AdityaRezan/8051-hardware-lab/docs/guide/video/frames/flash-wiring.jpg

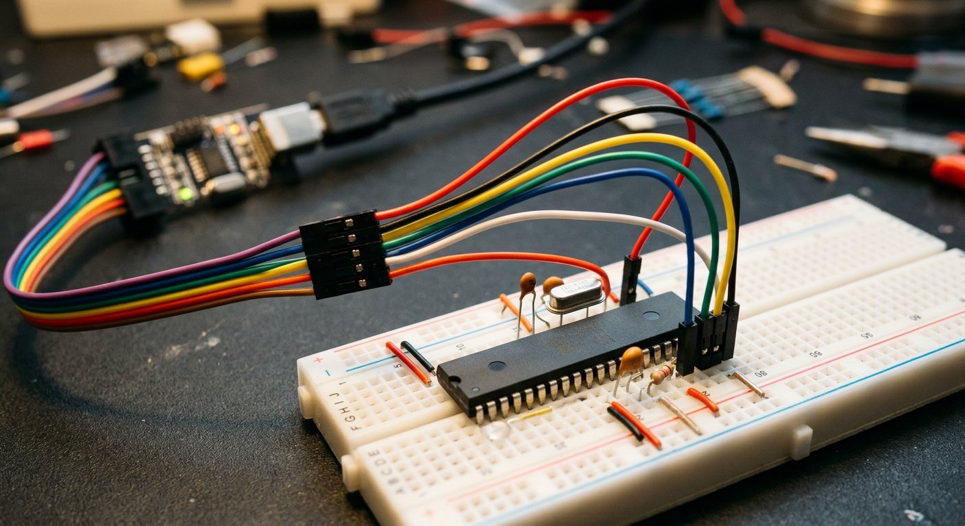
docs/guide/video/frames/flash-wiring.jpg
