AdityaRezan/8051-hardware-lab/docs/guide/images/dipswitch.jpg

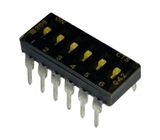
docs/guide/images/dipswitch.jpg
