AdityaRezan/8051-hardware-lab/README.md

# 8051 Hardware Lab

**Real-time embedded monitoring on the AT89S52 - from browser simulator to measured silicon.**

A complete, buildable 8051 board: shared-bus architecture, Keil C51 firmware, schematic with
derived design constants, bill of materials, a ten stage assembly procedure and twenty bench tests.

**Authors:** ATHARVA (24BEL0082) and ADITYA (24BEL0087)
**Department:** Electronics and Communication Engineering
**Academic year:** 2025-26

**New here? Read [`START_HERE.md`](START_HERE.md) first.** It walks the whole
project in the order you actually do it: install Keil, build all 13 programs,
build the board stage by stage, wire the programmer, flash, power on.

---

## The problem this project solves

The peripherals need **54 I/O lines**. The 8051 provides **32**.

| Peripheral | Dedicated pins | After bus sharing |
|---|---:|---:|
| LED latch, segment latch, LCD, ADC data | 32 | 8 |
| DIP switch bank | 8 | 8 |
| Control strobes | 0 | 8 |
| UART, interrupts, relay, buzzer, digit selects | 14 | 8 |
| **Total** | **54** | **32** |

The eight data lines of the LCD, the ADC and the two output latches are merged into one
bidirectional bus on port 0. Each device keeps its own enable strobe on port 2, so a transfer only
affects the device whose strobe is pulsed. No port expander IC is used.

---

## What the board does

| Function | Hardware | Firmware entry point |
|---|---|---|
| Eight LED output bank | 74HC573 latch plus 470 Ohm resistors | `led_write` |
| Eight bit digital input | 8-way DIP switch on port 1 | `switch_read` |
| Two digit numeric display | second latch, two BC547 digit drivers | `seg_tick` from timer 0 |
| Text output | 16x2 HD44780, 8-bit mode | `lcd_string`, `lcd_number` |
| Analog temperature | LM35 into ADC0804, Vref/2 at 1.000 V | `adc_read`, `adc_to_celsius` |
| Serial link | MAX232 and DB9 at 9600 8N1 | `uart_string`, `uart_number` |
| Interrupts | PB1 on INT0, PB2 on INT1, falling edge | `int0_isr`, `int1_isr` |
| Actuators | 5 V SPDT relay and buzzer on BC547 drivers | `RELAY`, `BUZZER` |
| Zone control | green, yellow, red LEDs plus relay and buzzer | `12_industrial_monitor.c` |

---

## Specification

| Parameter | Value |
|---|---|
| Microcontroller | AT89S52-24PU, 40-pin DIP (AT89C51 fallback, pin compatible) |
| Crystal | 11.0592 MHz |
| Machine cycle | 1.0851 microseconds |
| Supply | 7-12 V in, 5.00 V regulated by a 7805 with heatsink |
| Current | 157 mA typical, 274 mA peak |
| Digital I/O | 32 of 32 pins used |
| Serial | 9600 8N1, TH1 = FDH, zero percent error |
| ADC | 8-bit, Vref/2 = 1.000 V, 7.8125 mV per LSB |
| Temperature | 0 to 199.2 C at 0.78 C resolution |
| Display refresh | 100 Hz per digit from a 5 ms timer 0 interrupt |
| Cost | about INR 985 per board, INR 1,715 for a full setup |

---

## Repository layout

```
8051-hardware-lab/
├── hardware/
│   ├── SCHEMATIC.md      pin budget, pin allocation, wiring tables, design calculations
│   ├── BOM.md  BOM.csv   bill of materials with indicative Indian pricing
│   ├── ASSEMBLY.md       ten stage build procedure with a pass measurement per stage
│   ├── TESTING.md        twenty test cases, calibration, sample telemetry
│   └── min-system.svg    schematic of the minimum system
├── firmware/
│   ├── inc/board.h       pin definitions and all peripheral drivers
│   ├── src/01..13_*.c    thirteen standalone Keil C51 programs
│   ├── keil/*.uvprojx    uVision 5 projects for AT89S52 and AT89C51
│   ├── hex/              the 13 built HEX files, committed as the deliverable
│   └── README.md         Keil setup, flashing, program reference
├── docs/
│   ├── 8051_Hardware_Lab_Review_Deck.pptx   7 slide technical review deck
│   ├── 8051_Hardware_Implementation.pptx    28 slide detailed deck
│   ├── SOFTWARE_RUNBOOK.md  software half only: build, flash, run, lab day
│   ├── FACULTY_DEMO.md  demo-day playbook: bench setup, 12 min script, viva bank
│   ├── WORK_DIVISION.md the project in 13 parts, split between two authors
│   ├── RESULTS.md       what the results are, and the six minute one-on-one
│   ├── 8051_Results_Sheet.pdf  two page A4 sheet the reviewer holds
│   ├── DEMO_CARD.md     one printable page to keep under the board
│   └── guide/
│       ├── 8051_How_It_Works.pdf            18 page plain English guide
│       └── images/                          source photos and illustrations
│   ├── DECK_OUTLINE.md  wireframes, content spec and visual asset manifest
│   └── wireframes.svg   layout blueprints for all seven slides
├── tools/                generators for the decks, the BOM and the schematic
└── smart_industrial_automation.py    phase 1 simulation model
```

---

## Firmware

Thirteen Keil C51 programs. Each is a single translation unit that includes `inc/board.h`, so every
program builds as its own target.

| Program | Demonstrates |
|---|---|
| 01_led_blink | port expansion through a latch |
| 02_led_patterns | rotate and pattern sequences |
| 03_switch_led | debounced digital input |
| 04_seg7_counter | lookup table and multiplexed display |
| 05_timer0_second | timer interrupt timing |
| 06_square_wave | timer generated frequency |
| 07_ext_interrupt | INT0 and INT1 edge triggered ISRs |
| 08_uart_echo | 9600 baud serial link |
| 09_uart_commands | serial command shell |
| 10_adc_7seg | LM35 and ADC0804 |
| 11_adc_lcd | HD44780 8-bit interface |
| 12_industrial_monitor | complete system: zones, relay, buzzer, telemetry |
| 13_selftest | power on self test with a PASS or FAIL report |

Sources contain no comments and use only the C51 subset: `sbit`, `code`, `interrupt N`, C89
declarations. All thirteen compile clean. See `firmware/README.md` for the Keil setup and the
flashing procedure.

---

## Key design constants

Every value below derives from the 1.0851 microsecond machine cycle.

| Quantity | Value | Derivation |
|---|---|---|
| TH1 for 9600 baud | FDH | `256 - 11059200 / (384 x 9600) = 253` |
| Timer 0, 5 ms display tick | EE00H | `65536 - 5000 / 1.0851 = 60928` |
| Timer 0, 50 ms tick | 4C00H | `65536 - 50000 / 1.0851 = 19456` |
| Timer 0, 1 kHz output | FE34H | `65536 - 500 / 1.0851 = 65076` |
| ADC step | 7.8125 mV | `2.000 V / 256` |
| Temperature transfer | `T = raw x 25 / 32` | `raw x 7.8125 mV / 10 mV` |
| ADC clock | 606 kHz | `1 / (1.1 x 10 kOhm x 150 pF)` |
| LED resistor | 470 Ohm | keeps the latch package at 53 mA, under its 70 mA limit |

---

## Build and test

1. Read `hardware/SCHEMATIC.md` for the pin allocation and wiring tables.
2. Order parts from `hardware/BOM.csv`.
3. Follow `hardware/ASSEMBLY.md`, ten stages, measuring at the end of each.
4. Flash a program from `firmware/src` with a USBasp.
5. Run the twenty tests in `hardware/TESTING.md` and record the measured column.

---

## Presentation decks

| Deck | Slides | Use |
|---|---:|---|
| `docs/8051_Hardware_Lab_Review_Deck.pptx` | 7 | technical review committee, executive summary |
| `docs/8051_Hardware_Implementation.pptx` | 28 | detailed walkthrough, full subsystem coverage |

The seven slide deck is built to an explicit design system: charcoal `#1E293B`, off-white
`#F1F5F9`, Electric Blue `#2563EB` and Emerald `#10B981`, on a 12 column grid. Its layout
wireframes, per-slide content specification and visual asset manifest are in
`docs/DECK_OUTLINE.md`, and `docs/wireframes.svg` is the blueprint contact sheet.

Rebuild either deck with:

```
pip install python-pptx
python3 tools/build_exec_deck.py      # 7 slide review deck
python3 tools/build_deck.py           # 28 slide detailed deck
python3 tools/gen_wireframes.py       # docs/wireframes.svg
python3 tools/build_guide_pdf.py      # docs/guide/8051_How_It_Works.pdf
python3 tools/build_video.py          # docs/guide/video/8051_Assembly_and_Run.mp4
python3 tools/gen_bom.py              # hardware/BOM.md
python3 tools/gen_min_system_svg.py   # hardware/min-system.svg
python3 tools/build_results_pdf.py    # docs/8051_Results_Sheet.pdf
```

---

## Plain English guide

`docs/guide/8051_How_It_Works.pdf` is an 18 page guide written for a reader with no
electronics background. It covers the two halves of the project separately, then the join
between them, then the physical build, then two full walkthroughs (a button press and a rise
in temperature), and finishes with test results, a glossary and a script for presenting the
work. It uses real photographs of every part alongside three generated illustrations of the
concepts that cannot be photographed, namely the shared bus, the boundary between code and
pin, and the four beat control loop.

| Page | Subject |
|---|---|
| 1 | Cover |
| 2 | The whole project in one paragraph |
| 3 | Two halves of one machine |
| 4 | The parts you can touch |
| 5 | The parts that make the rest work |
| 6 | The code: thirteen small programs |
| 7 | Where the software touches the metal |
| 8 | The problem: 54 wires, 32 pins |
| 9 | The fix: one road, many gates |
| 10 | The loop: read, convert, decide, act |
| 11 to 12 | Building it, stage by stage |
| 13 to 14 | What happens when you press the button, and when the room gets hot |
| 15 | How we checked it was right |
| 16 | The numbers |
| 17 | Plain English glossary |
| 18 | How to present this project |

Rebuild with `python3 tools/build_guide_pdf.py`. It needs `weasyprint` and `pillow`.

## Video

There are two narrated videos, both 1280 by 720 at 24 fps with burned in
captions, so both read with the sound off.

| Video | Length | What it covers |
|---|---|---|
| `8051_Start_To_Finish.mp4` | 6:43 | The whole project from an empty desk: installing Keil on the laptop, `board.h` and the pin map, writing and building to a `.hex` file, all ten assembly stages, then flashing over SPI and running the system |
| `8051_Assembly_and_Run.mp4` | 5:13 | Assembly focused cut: the 54 versus 32 pin constraint, the shared bus fix, the ten build stages, and the board running |

Start with `8051_Start_To_Finish.mp4` if you want the complete story. The
shorter one is the better pick if you only have five minutes.

Both videos show real source code on screen. The excerpts in the code panels are
read out of `firmware/inc/board.h` and `firmware/src/12_industrial_monitor.c` at
build time, so they cannot drift from the actual firmware.

| File | What it is |
|---|---|
| `8051_Start_To_Finish.mp4` | the full start to finish video |
| `8051_Assembly_and_Run.mp4` | the shorter assembly cut |
| `SHOOTING_SCRIPT.md` | shot by shot script for filming the real board to the same narration |
| `audio/`, `audio_full/` | recorded narration clips, one per scene, per video |
| `frames/` | generated board and bench images used as source frames |

The board and bench images are generated: they show the build rather than
photograph it, because no camera was available. `SHOOTING_SCRIPT.md` has the
timecodes, camera setup and cut list needed to replace them with real footage of
the bench without re-recording anything.

The board images are generated: they show the build rather than photograph it,
because no camera was available. `SHOOTING_SCRIPT.md` has the timecodes, camera
setup and cut list needed to replace them with real footage of the bench
without re-recording anything.

Rebuild with:

```
python3 tools/build_video.py                    # 5:13 assembly cut, about 4 min
python3 tools/build_video.py --script full      # 6:43 full start to finish, about 5 min
python3 tools/build_video.py --script full --shot 340   # one frame, for tweaking
```

## Working on your own laptop

`docs/LAPTOP_SETUP.md` covers installing Keil C51, opening the 26 ready made
uVision projects, and building to a `.hex` file. `docs/SOFTWARE_RUNBOOK.md`
compresses the software half into one tick-box list with a minute-by-minute lab
day timeline, from installing Keil to a board that boots on its own power.
`docs/FLASHING.md` then covers
getting that file into the chip: the six ISP wires, an Arduino as ISP, USBasp,
ProgISP, and a fault table. Together they cover four things that reliably waste
a day:

- The free Keil C51 evaluation version is capped at **2 KB of object code** and
  links at offset `0x0800`. Program 01 measures `data=30.0 code=1129` on that
  toolchain, and every program carries the whole of `board.h`, so the later ones
  sit close to the cap. Enabling the LX51 linker with `REMOVEUNUSED` drops the
  unused drivers and buys a lot of room.
- The `0x0800` offset is harmless on an 8 KB part. The linker plants an `LJMP`
  at address 0x0000, so the chip boots and runs normally. It only matters on a
  2 KB device such as an AT89C2051.
- A **stock USBasp cannot program an AT89S52**. AVR chips reset on a low signal
  and the 8051 resets on a high one, so stock firmware never gets the chip into
  programming mode. Use an Arduino as ISP or a dedicated 8051 programmer.
- The **AT89C51 cannot be ISP programmed at all**. It needs a parallel
  programmer with 12 V VPP. The `_AT89C51` projects compile, but use the
  `_AT89S52` ones for hardware.

For licence free checking at home on any operating system, `tools/check_sdcc.py`
compiles all 13 programs with SDCC in a scratch directory and reports code
sizes. It translates the Keil syntax automatically and never modifies the files
in `firmware/`.

```
python3 tools/check_sdcc.py          # needs sdcc on PATH
python3 tools/check_sdcc.py 05 12    # only those two programs
```

## Safety

- The relay is mains rated but must never be connected to mains during laboratory demonstration.
  Use a 5 V or 12 V lamp on J4, or leave the contacts open.
- The 7805 dissipates about 1 W at 9 V and 250 mA. Fit the heatsink.
- Disconnect power before inserting or removing the microcontroller.
- Set DIP switches 6, 7 and 8 to OFF before every programming cycle; they share P1.5 to P1.7 with
  the SPI programming lines.
