AdityaRezan/8051-hardware-lab/docs/8051_Hardware_Lab_Review_Deck.pptx

MINI PROJECT / MICROPROCESSORS AND MICROCONTROLLERS

8051 Hardware Lab

Real-time embedded monitoring on the AT89S52

From browser simulator to measured silicon in one build cycle

Authors ATHARVA (24BEL0082) - ADITYA (24BEL0087)

Department Electronics and Communication Engineering

Academic year 2025 - 26

Review Technical Review Committee

Artifacts Schematic, BOM, 13 Keil C51 programs, test report

AT89S52

SYSTEM ID

Target AT89S52-24PU

Clock 11.0592 MHz

Bus 8-bit shared, P0

Firmware Keil C51, 13 programs

32 / 32

I/O PINS UTILISED

full allocation, no headroom

0.00 %

UART BAUD ERROR

TH1 = FDH at 11.0592 MHz

0.78 C

ADC RESOLUTION

Vref/2 trimmed to 1.000 V

INR 985

BOM PER BOARD

through-hole, single unit

## Slide 2

SLIDE 02 / PROBLEM

Problem statement and constraints

What had to be solved before a single component was placed

ID | Constraint | Consequence if ignored | Mitigation in this design
C1 | 32 I/O pins for 54 signals | peripherals dropped, or an expander IC added | single 8-bit bus on P0 with per-device strobes on P2
C2 | P0 is open drain | the bus never reaches a valid logic 1 | RN1, a 10 kOhm x 9 SIP network, pulls the bus up
C3 | Output latches cannot be read | a stale byte is latched into the wrong device | bus_shadow variable plus interrupt gating on transfers
C4 | SW6-SW8 share the ISP lines | in-circuit programming fails or is corrupted | 1 kOhm series resistors and a documented OFF state
C5 | 8-bit ADC, 5 V default reference | 1.95 C per step, most of the range wasted | Vref/2 trimmed to 1.000 V, giving 0.78 C per step
C6 | No hardware debounce on the buttons | one press registers as several interrupts | 5 ms resampling and edge triggered IT0 and IT1

PROBLEM STATEMENT

Transfer the verified 8051 programs from a software model onto a physical AT89S52, interfacing eight LEDs, a two digit seven segment display, a 16x2 character LCD, an eight way DIP switch bank, an LM35 temperature sensor through an ADC0804, a MAX232 serial link, a relay and a buzzer, and confirm on the bench that every output matches the value the simulator predicted.

Hard constraint:
the peripherals require 54 I/O lines and the 8051 provides 32. The architecture must close a 22 pin deficit without adding a port expander IC.

DESIGN CONSTRAINTS

I/O budget 54 required, 32 available

Port 0 topology open drain, cannot source

Latch read-back no read path to the latches

ISP contention P1.5-P1.7 shared with SPI

ADC resolution 8 bits, reference is a choice

No HW debounce buttons bounce 1 to 10 ms

constraint register C1-C6

8051 HARDWARE LAB / ECE 2025-26

02 / 07

## Slide 3

SLIDE 03 / ARCHITECTURE

System block diagram

One shared 8-bit bus resolves the 22 pin deficit

BD0 - BD7 shared 8-bit data bus port 0 10 kOhm pull-ups

Interface | Width | Signals | Direction | Device
Parallel bus | 8 bit | BD0-BD7 | bidirectional | U2 U3 LCD1 U4
Latch strobe | 1 bit | LED_LE SEG_LE | output | U2 U3
LCD control | 3 bit | E RS RW | output | LCD1
ADC control | 3 bit | WR RD INTR | in / out | U4
Serial + GPIO | 6 bit | TxD RxD P3.4-P3.7 | both | MAX232 Q1-Q4

SW1 8-way DIP

P1.0-P1.7

AT89S52-24PU

40-pin DIP / 11.0592 MHz

Relay + buzzer

P3.4 / P3.5

PB1 / PB2

P3.2 / P3.3

Digit selects

P3.6 / P3.7

LM35 sensor

ADC Vin+

MAX232 / DB9

P3.0 / P3.1

U2 74HC573

8 LEDs

P2.0 LED_LE

U3 74HC573

7-segment x2

P2.1 SEG_LE

LCD1 16x2

HD44780 8-bit

P2.2-P2.4 E RS RW

U4 ADC0804

LM35 8-bit

P2.5-P2.7 WR RD INTR

PIN ECONOMY

54 pins required -> 32 available
Three 8-bit data paths merged into one bus, saving 24 pins.
Eight of them pay for the strobes. Net saving: 16 pins.

single bus, four devices, eight strobes

8051 HARDWARE LAB / ECE 2025-26

03 / 07

## Slide 4

SLIDE 04 / STACK

Hardware and software stack

Four layers, one board, no operating system

13 firmware programs / board.h / 01 blink to 13 self test

bus, LED, 7-segment, LCD, ADC, UART, switch debounce

8-bit parallel / HD44780 8-bit / ADC0804 / UART 9600 8N1

AT89S52 2x 74HC573 ADC0804 LM35 MAX232 HD44780 BC547 x4 7805

APPLICATION

firmware/src

DRIVER

firmware/inc/board.h

INTERFACE

P0, P2, P3

SILICON

through-hole DIP

AT89S52-24PU

MCU

8 KB flash, 3 timers

74HC573 x2

LATCH

LED bank, segment patterns

ADC0804LCN

ADC

8-bit parallel, 606 kHz

LM35DZ

SENSOR

10 mV per degree C

MAX232N

TRANSCEIVER

TTL to RS-232, 1 uF pump

JHD162A

DISPLAY

16x2 HD44780, 8-bit

BC547 x4

DRIVER

digits, relay, buzzer

L7805CV

REGULATOR

5.00 V, 1 W, heatsinked

Protocol | Pins | Used for
8-bit parallel bus | P0.0-P0.7 | latches, LCD, ADC
UART 9600 8N1 | P3.0-P3.1 | telemetry and shell
SPI (ISP only) | P1.5-P1.7 | flash programming

8051 HARDWARE LAB / ECE 2025-26

TOOLCHAIN

Keil uVision 5, C51, level 8, small memory model
USBasp + avrdude -p 8052 USB-RS232 DMM 20 MHz scope

no RTOS, no external memory, one translation unit per program

04 / 07

## Slide 5

SLIDE 05 / IMPLEMENTATION

Implementation logic and control flow

Interrupt driven display refresh around a polling control loop

board_init

ports, latches, outputs off

TIMER 0 ISR / EVERY 5 ms

TH0 = EEH TL0 = 00H
seg_tick() alternates the two digits
saves and restores the bus shadow byte

Stage | Operation | Failure mode handled
Acquire | adc_read, INTR both edges | guarded timeout returns
Convert | T = raw x 25 / 32 integer | no float library needed
Decide | compare at 400 and 700 | emergency overrides all
Actuate | latch write, relay, buzzer | interrupts gated
Publish | LCD, 7-segment, UART 1 Hz | refresh runs in the ISR

Operation | Cycles | Time
machine cycle | 12 osc | 1.0851 us
bus transfer | ~20 | 21.7 us
ADC conversion | - | 114 us
LCD write | ~30 | 32.6 us
display tick | 4608 | 5.000 ms
telemetry period | - | 1.000 s

display_init

timer 0 at 5 ms, EE00H

adc_read

start, wait INTR, read byte

BUS TRANSFER PRIMITIVE

1 save

ea = EA

2 gate

EA = 0

zone decision

T < 40 / < 70 / >= 70 C

3 place

BUS = v

4 strobe

LE = 1

actuate

LEDs, relay, buzzer

5 release

LE = 0

6 restore

BUS = shadow

EXTERNAL INTERRUPTS

INT0 falling edge -> emergency latch
INT1 falling edge -> clear the latch
Both ISRs set a flag only; the main loop
does the work, keeping service short.

WHY POLL, WHY INTERRUPT

The display must never flicker, so it runs
in the interrupt. Sensing and acting can
slip by milliseconds, so they poll. Each
mechanism is matched to its own deadline.

publish

LCD, 7-segment, UART 1 Hz

poll in the loop, refresh in the interrupt

8051 HARDWARE LAB / ECE 2025-26

05 / 07

## Slide 6

SLIDE 06 / RESULTS

Results, benchmarks and trade-offs

Derived values, measured targets and the decisions behind them

Decision | Alternative rejected | Trade-off accepted | Outcome
Shared 8-bit bus | I2C or SPI port expander IC | 8 extra strobes and software arbitration | 54 pins fitted into 32, no extra IC
AT89S52 with ISP | AT89C51, parallel programmer | slightly higher chip cost | programmer cost falls to INR 250
470 Ohm LED resistors | the usual 330 Ohm | about 15 % less brightness | 53 mA per package, inside the 70 mA limit
Vref/2 at 1.000 V | internal 2.5 V reference | one trimpot and one calibration step | 0.78 C per step instead of 1.95 C
Software driven bus | MOVX with an address latch | no hardware address decode | port 2 stays free for eight strobes
Flags inside the ISRs | doing the work in the ISR | one loop of latency | short, predictable service routines
Software debounce | RC filter or Schmitt trigger | 5 ms of loop time | no parts, no spare pins consumed

0.00 %

BAUD ERROR

TH1 = FDH at 11.0592 MHz

1.00 kHz

TIMER OUTPUT

FE34H reload, +0.17 %

100 Hz

DISPLAY REFRESH

EE00H reload, per digit

0.78 C

ADC RESOLUTION

7.8125 mV per step

157 mA

BOARD CURRENT

274 mA peak, relay on

3.4 KB

LARGEST PROGRAM

of 8 KB flash, 30 B RAM

20 bench tests, T1-T20, acceptance limits in hardware/TESTING.md

8051 HARDWARE LAB / ECE 2025-26

06 / 07

## Slide 7

SLIDE 07 / OUTLOOK

Scalability, future scope and conclusion

Where the architecture has headroom and where it does not

NOW

Single board, verified

13 programs, 20 tests

INR 985 per board

9600 baud telemetry

Recover two pins

LCD on a PCF8574 backpack

frees P2.3 and P2.4

adds I2C: RTC, EEPROM

Multi-node and PCB

RS-485 or ESP-01 link

KiCad two layer layout

mains rated enclosure

NEXT

LATER

CONCLUSION

A 22 pin deficit was closed by architecture, not by extra silicon.

Every constant derives from the 1.0851 microsecond machine cycle.

Thirteen programs compile clean; the build is staged and measured.

Every hardware result reconciles with the phase 1 simulator.

SCALABILITY LIMITS

shared P0 caps throughput, a few hundred kHz

one channel, 8-bit, about 114 us per sample

256 B RAM, no external data memory wired

two external sources, no priority nesting

demonstration only, never mains connected

Bus

ADC

Memory

Interrupts

Relay

repository: AdityaRezan/8051-hardware-lab

8051 HARDWARE LAB / ECE 2025-26

07 / 07
