AdityaRezan/8051-hardware-lab/docs/8051_Hardware_Implementation.pptx

MINI PROJECT - MICROPROCESSORS AND MICROCONTROLLERS

8051 Microcontroller:
Architecture Study, Assembly Programming and Simulation

Phase 2 - Hardware Implementation on a Real AT89S52

Target device: AT89S52-24PU, 40 pin DIP

Clock: 11.0592 MHz, 1.0851 us machine cycle

I/O used: 32 of 32 pins, shared 8-bit bus

Cost: about INR 985 per board

PHASE 2

Simulator verified 14 assembly and 5 C programs.
This phase builds the board, writes Keil C51 firmware, and measures every signal.

ACADEMIC YEAR
2025 - 26
Microprocessors and Microcontrollers

SUBMITTED BY
ATHARVA (24BEL0082) ADITYA (24BEL0087)
Department of Electronics and Communication Engineering

## Slide 2

OVERVIEW

From simulator to silicon

What phase 1 delivered and what phase 2 adds

What changes when the machine becomes real

Aspect | In the simulator | On the hardware
I/O | Ports written directly | Shared bus with latch strobes
Timing | Idealised machine cycles | 1.0851 us per cycle, measured on a scope
Inputs | Clicked switches, ideal | Bounce, pull-ups, noise, debounce needed
Analog | Slider sets the temperature | LM35 into ADC0804, reference must be calibrated
Serial | Terminal pane | MAX232, DB9 wiring, 9600 8N1
Failure | Program stops | Wrong Vref, reversed sensor, floating EA pin
Verification | Compare with hand calculation | Compare with a multimeter and a scope

8051 Microcontroller Hardware Lab | ATHARVA (24BEL0082) - ADITYA (24BEL0087)

PHASE 1 - DIGITAL MODEL (COMPLETE)

A browser based 8051 trainer with a two pass assembler and an instruction level simulator.
Fourteen assembly programs and five Embedded C programs were executed one instruction at a time and every register, flag and memory change was compared with hand calculation.
All fourteen programs verified.

PHASE 2 - REAL HARDWARE (THIS DECK)

The same ideas built on an AT89S52 with latches, a real ADC, a character LCD, a MAX232 serial link, a relay and a buzzer.
Thirteen Keil C51 programs replace the assembly sources, the board is assembled in ten measured stages, and twenty tests verify it on the bench.

2

## Slide 3

PROBLEM STATEMENT

Why the hardware phase is needed

"To transfer the verified 8051 programs from a software model to a physical AT89S52 trainer board, interfacing LEDs, a seven segment display, a DIP switch bank, a character LCD, an LM35 temperature sensor with an ADC0804, a MAX232 serial link, a relay and a buzzer, and to confirm on the bench that each output matches the value predicted by the simulator."

Difficulties the hardware phase has to solve

The peripherals need 54 I/O lines. The 8051 has 32. A shared 8-bit bus with latches closes the gap.

It cannot drive a logic 1 without pull-ups, and every bus transfer has to respect the resulting rise time.

Output states live in latches, so the firmware keeps a shadow byte for the bus and restores it after every transfer.

An 8-bit ADC needs a deliberate reference. Vref/2 is trimmed to 1.000 V so the LM35 range is used instead of wasted.

P1.5, P1.6 and P1.7 serve both the DIP switches and the SPI programming header, so the two must not fight.

8051 Microcontroller Hardware Lab | ATHARVA (24BEL0082) - ADITYA (24BEL0087)

1

Port shortage

2

Port 0 is open drain

3

No zero flag, no read back

4

Analog accuracy

5

Programming

3

## Slide 4

OBJECTIVES

What the hardware phase sets out to do

8051 Microcontroller Hardware Lab | ATHARVA (24BEL0082) - ADITYA (24BEL0087)

Build the minimum system

AT89S52 with an 11.0592 MHz crystal, a reset circuit, the EA strap and a regulated 5 V supply, verified by a 1.843 MHz signal on ALE.

Solve the port shortage

Put the LCD, the ADC and two output latches on one 8-bit bus so all 32 pins cover every peripheral on the board.

Interface real output hardware

Eight LEDs behind a latch, a two digit multiplexed seven segment display, a 16x2 character LCD.

01

02

03

Interface real input hardware

An eight way DIP switch bank with pull-ups and debouncing, plus two interrupt push buttons on INT0 and INT1.

Measure something real

LM35 into an ADC0804 with a calibrated reference, converting raw codes to degrees Celsius and driving zone decisions.

Verify against the simulator

Twenty bench tests with acceptance limits, so each hardware result can be compared with the value the simulator produced.

04

05

06

4

## Slide 5

SYSTEM ARCHITECTURE

How the board is organised

One 8-bit bus, four devices behind latches and strobes

8051 Microcontroller Hardware Lab | ATHARVA (24BEL0082) - ADITYA (24BEL0087)

P1

8 DIP switches

AT89S52

40 pin DIP, 11.0592 MHz

P2.0 / P2.1

latch enables

P3.2 / P3.3

INT0 and INT1

P2.2-P2.4

LCD E, RS, RW

P3.4 / P3.5

relay and buzzer

P2.5-P2.7

ADC WR, RD, INTR

data bus

P0

shared data bus

P3.0 / P3.1

UART to MAX232

8-bit data bus BD0-BD7, port 0, 10 kOhm pull-ups

U2 74HC573

8 LEDs

U3 74HC573

7-segment

LCD1 16x2

HD44780

U4 ADC0804

LM35

5

## Slide 6

DESIGN PROBLEM

The 8051 has 32 I/O pins and the board needs 54

Peripheral | Dedicated pins | After bus sharing | How the saving is made
8 LED output bank | 8 | 0 | moves behind latch U2 on the bus
7-segment segment lines | 8 | 0 | moves behind latch U3 on the bus
16x2 LCD | 11 | 3 | data lines move to the bus, RS RW E stay
ADC0804 | 11 | 3 | data lines move to the bus, WR RD INTR stay
8 way DIP switch | 8 | 8 | stays on port 1
Digit selects | 2 | 2 | stays on P3.6 and P3.7
UART | 2 | 2 | stays on P3.0 and P3.1
Interrupt buttons | 2 | 2 | stays on P3.2 and P3.3
Relay and buzzer | 2 | 2 | stays on P3.4 and P3.5
Control strobes | 0 | 8 | new: enables on port 2, replace the per-device data pins
TOTAL | 54 | 32 | exactly the 32 pins the 8051 provides

Bus rule used everywhere in the firmware:
place the byte on P0, pulse the enable, restore the shadow byte. Interrupts are disabled during LCD and ADC transfers so the 5 ms display refresh cannot corrupt a bus cycle.

8051 Microcontroller Hardware Lab | ATHARVA (24BEL0082) - ADITYA (24BEL0087)

Why this works

The LCD, the ADC and the two latches only hold data. None of them needs to be driven continuously.

Each one keeps its own enable line on port 2. A transfer writes a byte to port 0 and pulses exactly one enable, so only the addressed device captures the byte.

The bus is driven by software rather than by MOVX, which keeps port 2 free for those eight strobes and keeps the code readable.

6

## Slide 7

PIN ALLOCATION

All 32 pins accounted for

AT89S52, 40 pin plastic DIP, 11.0592 MHz

Three traps that make a board look dead
EA/VPP (pin 31) floating - the device fetches code from external memory and never runs.
P0 used without RN1 pull-ups - port 0 is open drain and cannot drive a logic 1.
DIP switches 6, 7 and 8 closed while programming - they short the SPI lines on P1.5 to P1.7.

8051 Microcontroller Hardware Lab | ATHARVA (24BEL0082) - ADITYA (24BEL0087)

Pin | Signal | Board net
39-32 | P0.0-P0.7 | BD0-BD7 shared data bus
1-5 | P1.0-P1.4 | SW1-SW5
6-8 | P1.5-P1.7 | SW6-SW8 and MOSI, MISO, SCK
21 | P2.0 | LED_LE
22 | P2.1 | SEG_LE
23 | P2.2 | LCD_E
24 | P2.3 | LCD_RS
25 | P2.4 | LCD_RW
26 | P2.5 | ADC_WR
27 | P2.6 | ADC_RD
28 | P2.7 | ADC_INTR

Pin | Signal | Board net
10 | P3.0 RxD | MAX232 R1OUT
11 | P3.1 TxD | MAX232 T1IN
12 | P3.2 INT0 | PB1 emergency button
13 | P3.3 INT1 | PB2 mode button
14 | P3.4 T0 | relay driver via JP1
15 | P3.5 T1 | buzzer driver
16 | P3.6 WR | DIG1 digit select
17 | P3.7 RD | DIG2 digit select
9 | RST | reset RC and PB3, ISP pin 5
18 | XTAL2 | crystal and 30 pF
19 | XTAL1 | crystal and 30 pF
31 | EA/VPP | tied to +5 V

7

## Slide 8

MINIMUM SYSTEM

Clock, reset, EA strap and decoupling

Four parts decide whether the board runs at all

Part | Value | Purpose | Measured
Y1 crystal | 11.0592 MHz | clock; gives exact 9600 baud | 11.0592 MHz on pin 18
C3a, C3b | 30 pF | crystal load capacitors | -
R1 | 10 kOhm | holds RST low in steady state | -
C2 | 10 uF | holds RST high for about 100 ms at power up | RST low when idle
PB3 | tactile | manual reset to +5 V | RST above 4 V when held
EA strap | wire to +5 V | selects internal flash | 5.00 V on pin 31
C1 | 0.1 uF | decoupling across pins 40 and 20 | 5.00 V, no ripple spike
ALE | output | clock divided by 6 | 1.843 MHz

TIMING

machine cycle = 12 oscillator periods
Tcy = 12 / 11.0592 MHz = 1.0851 microseconds
ALE = fosc / 6 = 1.8432 MHz (fastest proof the device is running)

8051 Microcontroller Hardware Lab | ATHARVA (24BEL0082) - ADITYA (24BEL0087)

AT89S52 (U1)

pin 40 VCC 5.00 V

pin 20 GND

pin 31 EA -> +5 V

pin 19 XTAL1

pin 18 XTAL2

pin 9 RST

pin 30 ALE

Reset rule
RST must stay above 1.2 V for at least two machine cycles, about 2.2 us.
The RC gives about 100 ms.

8

## Slide 9

SHARED BUS

How one byte reaches one device

The four steps every transfer follows, and why the shadow byte exists

8051 Microcontroller Hardware Lab | ATHARVA (24BEL0082) - ADITYA (24BEL0087)

Place the byte

BUS = value; the byte appears on P0.0 to P0.7 and is copied into bus_shadow.

Disable interrupts

EA = 0, so the 5 ms display refresh cannot overwrite the bus half way through.

Pulse the enable

One strobe line on port 2 goes high for about 2.7 us. Only the device wired to that strobe captures the byte.

Restore the bus

BUS = bus_shadow, then EA is restored. The other three devices never saw a strobe, so they are unaffected.

1

2

3

4

firmware/inc/board.h

void led_write(unsigned char v)
{
unsigned char ea_state;
ea_state = EA;
EA = 0;
bus_put(v);
LED_LE = 1;
delay_short();
LED_LE = 0;
EA = ea_state;
}

Why the shadow byte is not optional

Port 0 is quasi-bidirectional and open drain. Reading back a latch output is not possible, so the last value written is kept in a variable.

The display refresh interrupt writes segment patterns to the same bus every 5 ms. Without saving, restoring and gating, an interrupt landing between the byte and the strobe would load the wrong value into the LED latch and produce visible glitches.

The same pattern is used by seg_latch, lcd_write and adc_read.

9

## Slide 10

OUTPUT STAGE

Eight LED bank behind a 74HC573 latch

Active high outputs, one current limiting resistor per LED

Parameter | Value | Reason
Latch type | 74HC573 | transparent latch, CMOS inputs suit the port 0 pull-ups
Latch enable | P2.0 | rising edge captures the byte
Output enable | tied to GND | outputs permanently valid
Series resistor | 470 Ohm | 8 x 6.6 mA = 53 mA, inside the 70 mA package limit
Resistor not used | 330 Ohm | would give 75 mA and exceed the package rating
LED polarity | active high | latch output high lights the LED

led_write(0x0F); /* lower four LEDs on */
led_write(0xF0); /* upper four LEDs on */

8051 Microcontroller Hardware Lab | ATHARVA (24BEL0082) - ADITYA (24BEL0087)

P0 bus

BD0-BD7

U2 74HC573

LE <- P2.0, OE tied low

RN3

470 Ohm x 8

8 LEDs

to GND

Current arithmetic

I per LED = (5.0 - 1.9) / 470 = 6.6 mA
I per package = 8 x 6.6 = 53 mA
74HC573 package limit = 70 mA

Headroom = 17 mA, which is why 470 Ohm is specified instead of the more usual 330 Ohm. Brightness at 6.6 mA is ample for a modern high efficiency indicator.

10

## Slide 11

DISPLAY STAGE

Two digit seven segment display

Latched segments, transistor switched digits, 100 Hz refresh

Multiplexing
Timer 0 interrupts every 5 ms. The service routine turns both digits off, latches the digit 1 pattern, raises P3.6, and on the next interrupt does the same for digit 2 with P3.7.
Refresh rate per digit = 1 / (2 x 5 ms) = 100 Hz, above the flicker fusion limit.
Reload value: 65536 - 4608 = 60928 = EE00H, so TH0 = EEH and TL0 = 00H.

8051 Microcontroller Hardware Lab | ATHARVA (24BEL0082) - ADITYA (24BEL0087)

U3 74HC573

LE <- P2.1

RN4 470 Ohm

a b c d e f g dp

DSP1

2 digit common cathode

P0 bus

BD0-BD7

Digit cathodes

Q1 BC547

digit 1

Q2 BC547

digit 2

Digit | Pattern | Digit | Pattern | Note
0 | 3FH | 5 | 6DH | Q0 = a
1 | 06H | 6 | 7DH | Q1 = b
2 | 5BH | 7 | 07H | Q2 = c
3 | 4FH | 8 | 7FH | Q3 = d
4 | 66H | 9 | 6FH | Q4 = e

Bases via 4.7 kOhm from P3.6 and P3.7. Emitters to GND. A logic 1 on the base pulls the digit cathode to ground and lights that digit.

11

## Slide 12

INPUT STAGE

DIP switches, pull-ups and interrupt buttons

Every input is active low, so a closed switch reads as zero

Debouncing

8051 Microcontroller Hardware Lab | ATHARVA (24BEL0082) - ADITYA (24BEL0087)

Eight way DIP switch on port 1

Each contact pulls its pin to ground through the switch. RN2, a 10 kOhm x 9 SIP network, pulls every pin back to +5 V when the switch is open.

Closed reads 0, open reads 1. Port 1 has internal pull-ups, so the board would work without RN2, but the external network makes the input immune to noise on long breadboard wires.

P1.5, P1.6 and P1.7 have 1 kOhm series resistors so a closed switch cannot fight the ISP programmer during flashing.

Interrupt push buttons

PB1 on P3.2 (INT0) and PB2 on P3.3 (INT1), each pulled up by 4.7 kOhm and switching to ground.

TCON is set with IT0 = 1 and IT1 = 1 so the 8051 detects the falling edge, giving one interrupt per press.

The service routines only set a flag. All the work is done in the main loop, which keeps the interrupt short and makes the behaviour easy to reason about.

unsigned char switch_read(void)
{
unsigned char a, b;
a = SWITCH;
do { delay_ms(5); b = SWITCH; } while (b != a);
return b;
}

Why 5 ms

A mechanical contact bounces for 1 to 10 ms. Sampling every 5 ms until two consecutive reads agree removes the bounce without slowing the response, because the whole loop finishes in one or two samples.

12

## Slide 13

ANALOG INPUT

LM35 temperature sensor with an ADC0804

Vref/2 trimmed to 1.000 V so the sensor range is used, not wasted

Quantity | Value | Note
Vref/2 (pin 9) | 1.000 V | set with the R8 trimpot, not left open
Full scale input | 2.000 V | twice the reference voltage
Step size | 7.8125 mV | 2.000 V / 256
Temperature per step | 0.781 degree C | 7.8125 mV / (10 mV per degree C)
Transfer function | T = raw x 25 / 32 | integer arithmetic, no float library
Range | 0 to 199.2 degree C | well past anything the LM35 sees in a lab
Clock | 606 kHz | 1 / (1.1 x 10 kOhm x 150 pF)
Conversion time | about 114 us | 66 to 73 clock periods
LM35 output at 30 C | 300 mV | raw code 38, displayed 29

8051 Microcontroller Hardware Lab | ATHARVA (24BEL0082) - ADITYA (24BEL0087)

ADC0804

Vin+ pin 6, Vin- to GND

P0 bus

DB0-DB7

8051

adc_read()

LM35

10 mV per degree C

control

WR P2.5
RD P2.6
INTR P2.7

Read sequence
Pulse WR low to start. Wait for INTR to go high, then low. Drive RD low, read the byte, release RD.

Why not leave Vref/2 open
An open pin selects the internal 2.5 V reference, giving 0 to 5 V full scale. The LM35 only reaches 1.5 V at 150 C, so more than two thirds of the range would be wasted and the resolution would be 1.95 degrees C instead of 0.78.

13

## Slide 14

TEXT OUTPUT

16x2 character LCD on the shared bus

HD44780 compatible module in 8-bit mode, three control lines

LCD pin | Name | Connected to | Function
1 | VSS | GND | ground
2 | VDD | +5 V | logic supply, 0.1 uF to ground
3 | VO | R9 wiper | contrast, about 0.5 to 1.0 V
4 | RS | P2.3 | 0 = command, 1 = character data
5 | RW | P2.4 | 0 = write, 1 = read
6 | E | P2.2 | enable, data taken on the falling edge
7-14 | D0-D7 | BD0-BD7 | 8-bit data on the shared bus
15 | A | +5 V via 220 Ohm | backlight anode
16 | K | GND | backlight cathode

Timing and the shared bus
The enable pulse stays high for about 8 machine cycles, roughly 8.7 us, far above the 450 ns minimum the HD44780 needs. Commands wait 2 ms afterwards so the clear and home instructions can complete.
Because the data pins sit on the shared bus, lcd_write brackets the transfer the same way as every other driver: save, write, strobe, restore, with interrupts disabled.
RW is driven from P2.4 so the busy flag can be polled. The shipped driver uses fixed delays instead, so RW may be tied to ground to free one pin.

8051 Microcontroller Hardware Lab | ATHARVA (24BEL0082) - ADITYA (24BEL0087)

INITIALISATION

lcd_cmd(0x38); /* 8-bit, 2 lines, 5x7 */
lcd_cmd(0x0C); /* display on, cursor off*/
lcd_cmd(0x06); /* increment on write */
lcd_cmd(0x01); /* clear display */
lcd_gotoxy(0, 0);
lcd_string("8051 HARDWARE");

14

## Slide 15

SERIAL LINK

MAX232 and DB9 at 9600 baud

The reason the board uses 11.0592 MHz instead of 12 MHz

8051 Microcontroller Hardware Lab | ATHARVA (24BEL0082) - ADITYA (24BEL0087)

MAX232 pin | Name | Connected to
1, 3 | C1+ , C1- | C7a, 1 uF
4, 5 | C2+ , C2- | C7b, 1 uF
2 | V+ | C7c to +5 V, not to ground
6 | V- | C7d, positive leg to ground
11 | T1IN | P3.1 TxD
12 | R1OUT | P3.0 RxD
13 | R1IN | DB9 pin 3
14 | T1OUT | DB9 pin 2
15, 16 | GND, VCC | ground and +5 V

Configuration
SCON = 0x50 mode 1, 8 data bits, receive enabled
TMOD timer 1 in mode 2, 8-bit auto reload
PCON SMOD cleared
Error 0.0 percent at 11.0592 MHz
Error 8.5 percent at 12 MHz, which fails

BAUD RATE

TH1 = 256 - (11059200 / (384 x 9600))
= 256 - 3 = 253 = 0xFD
SMOD = 0, timer 1 in mode 2

DB9 wiring

The board connector is wired as DCE: T1OUT to pin 2 and R1IN to pin 3, so a straight through cable works with a USB to RS-232 adapter. If the terminal shows nothing, swap pins 2 and 3 first, then check that V+ is about +9 V and V- about -9 V.

TELEMETRY AT 9600 8N1

T=28.1C ADC=36 ZONE=SAFE FAN=0 BUZ=0
T=41.4C ADC=53 ZONE=WARNING FAN=1 BUZ=0
T=72.6C ADC=93 ZONE=DANGER FAN=1 BUZ=1
T=72.6C ADC=93 ZONE=EMERGENCY FAN=0 BUZ=1

15

## Slide 16

POWER

Regulated 5 V and the current budget

A 7805, its heatsink, and knowing how much current the board really draws

Supply chain
J1 barrel jack, 7 to 12 V in, centre positive -> 1N4007 reverse protection -> C4 100 uF and 0.1 uF -> L7805 with heatsink -> C5 100 uF and 0.1 uF -> 5 V rail
A 500 mA adapter is comfortable. Below 7 V input the 7805 drops out of regulation; above 12 V the dissipation becomes the limiting factor, not the current.

8051 Microcontroller Hardware Lab | ATHARVA (24BEL0082) - ADITYA (24BEL0087)

Load | Typical | Maximum
AT89S52 at 11.0592 MHz | 25 mA | 30 mA
U2 latch plus 8 LEDs | 53 mA | 53 mA
U3 latch plus one display digit | 53 mA | 53 mA
16x2 LCD logic and backlight | 10 mA | 14 mA
ADC0804 | 3 mA | 5 mA
MAX232 | 10 mA | 15 mA
LM35 | 0.1 mA | 0.2 mA
Transistor base currents | 3 mA | 4 mA
Relay coil when energised | 0 mA | 70 mA
Buzzer when sounding | 0 mA | 30 mA
TOTAL | 157 mA | 274 mA

Regulator dissipation

P = (Vin - Vout) x I = (9 - 5) x 0.25 = 1.0 W

One watt in a TO-220 without a heatsink runs hot enough to drop out. HS1 is not optional.

Decoupling

C1 0.1 uF across pins 40 and 20 of the microcontroller, plus one 0.1 uF capacitor at each of U2, U3, U4, U5, the LCD and the ADC. Ceramic, short leads, physically close to the pins.

16

## Slide 17

BILL OF MATERIALS

Parts, quantities and cost

Indicative Indian retail rates, 2025-26 academic year

Category | Line items | Cost (INR)
Semiconductors and ICs | AT89S52, two 74HC573, ADC0804, MAX232, LM35, 7805 | 397
Discretes | four BC547, two 1N4007, nine LEDs | 21
Displays, modules, actuators | 16x2 LCD, 2-digit display, 5 V relay, buzzer | 275
Switches and buttons | 8-way DIP switch, three tactile buttons | 39
Resistors and networks | four SIP networks, nine resistors, trimpot, pot | 82
Capacitors | crystal loads, electrolytics, ceramics, 1 uF pump caps | 35
Crystal | 11.0592 MHz | 12
Sockets, connectors, jumpers | IC sockets, DC jack, DB9, ISP header, terminals | 124
Power, PCB, wire, programmers | adapter, dot PCB, hookup wire, USBasp, USB-RS232 | 730
TOTAL, one complete setup | | 1,715
Recurring cost of a second board | the adapter and programmers are reused | 985

What is not on the bill
A digital multimeter and, ideally, a 20 MHz oscilloscope for the four tests that need one. Both are standard laboratory instruments and are shared across the batch.
A reference thermometer for calibrating the LM35 against a known temperature.

8051 Microcontroller Hardware Lab | ATHARVA (24BEL0082) - ADITYA (24BEL0087)

Sourcing notes

AT89S52 over AT89C51: SPI programming with a 250 rupee USBasp instead of a parallel programmer costing several thousand.

74HC573 over 74LS573: CMOS inputs suit port 0 pull-ups and load the bus less.

MAX232A or MAX3232 may be substituted with 0.1 uF pump capacitors.

The display must be common cathode; a common anode part inverts the whole design.

17

## Slide 18

FIRMWARE ARCHITECTURE

One header, thirteen programs

firmware/inc/board.h holds every pin definition and driver

bus_put, led_write, seg_latch, seg_tick

lcd_init, lcd_string, adc_read, uart_string

adc_to_celsius, seg_number, uart_number, lcd_number

main and the interrupt service routines

8051 Microcontroller Hardware Lab | ATHARVA (24BEL0082) - ADITYA (24BEL0087)

src/01 .. src/13

one file per program

Design rules

No comments in the sources
No emojis anywhere
C89 declarations only
Keil keywords: sbit, code, interrupt N
No printf, no floating point
Each program is one translation unit

inc/board.h

pin definitions, bus and peripheral drivers

Hardware layer

moves bytes and strobes the enables

Peripheral layer

device protocols and timing

Conversion layer

raw values to human units

Application layer

what each program actually does

18

## Slide 19

PROGRAM LIBRARY

Thirteen Keil C51 programs

Each builds as its own target and fits inside the 8 KB flash of the AT89S52

# | Program | Peripherals exercised | What to observe | Size

01 | led_blink | LED latch | eight LEDs toggle every 500 ms | 1.1 KB
02 | led_patterns | LED latch | running light, AAH, 55H, blink | 1.2 KB
03 | switch_led | DIP switches, LEDs | LEDs follow switches, flash above 80H | 1.2 KB
04 | seg7_counter | 7-segment, digits | 00 to 99 at two counts per second | 1.3 KB
05 | timer0_second | timer 0 | one second blink from the interrupt | 1.2 KB
06 | square_wave | timer 0, P3.4 | 1.00 kHz on a scope, JP1 removed | 1.1 KB
07 | ext_interrupt | INT0, INT1 | PB1 alternates 0FH and F0H, PB2 counts | 1.3 KB
08 | uart_echo | UART, MAX232 | banner and character echo | 1.4 KB
09 | uart_commands | UART, relay, buzzer | HLP, LED HH, SEG NN, RLY N, TMP | 3.0 KB
10 | adc_7seg | ADC0804, LM35 | temperature on the display | 1.5 KB
11 | adc_lcd | ADC, LCD | temperature and bar graph | 2.0 KB
12 | industrial_monitor | everything | zones, relay, buzzer, telemetry | 3.4 KB
13 | selftest | everything | PASS or FAIL report on the terminal | 2.6 KB

Verification:
all thirteen compiled with zero errors and zero warnings. The largest, program 12, uses about 40 percent of the flash and about 30 bytes of internal RAM.

8051 Microcontroller Hardware Lab | ATHARVA (24BEL0082) - ADITYA (24BEL0087)

19

## Slide 20

FIRMWARE TIMING

Every constant the programs depend on

All derived from one number: the 1.0851 microsecond machine cycle

Function | Register setting | Derivation | Result
UART 9600 baud | TH1 = TL1 = FDH | 256 - 11059200 / (384 x 9600) = 253 | 0.00 percent error
Display refresh 5 ms | TH0 = EEH, TL0 = 00H | 65536 - 5000 / 1.0851 = 60928 | 100 Hz per digit
50 ms tick | TH0 = 4CH, TL0 = 00H | 65536 - 50000 / 1.0851 = 19456 | 20 ticks = 1 s
1 kHz output | TH0 = FEH, TL0 = 34H | 65536 - 500 / 1.0851 = 65076 | 1001.7 Hz
Bus strobe width | 8 NOPs | 8 x 1.0851 us | 8.7 us, above all minimums
LCD command wait | delay_ms(2) | calibrated DJNZ loop | covers clear and home
Switch debounce | delay_ms(5) | two consecutive equal samples | 1 to 10 ms bounce removed
LM35 conversion | T = raw x 25 / 32 | raw x 7.8125 mV / 10 mV | 0.78 degree C per step

8051 Microcontroller Hardware Lab | ATHARVA (24BEL0082) - ADITYA (24BEL0087)

DISPLAY REFRESH INTERRUPT

void timer0_isr(void) interrupt 1
{
TH0 = TH0_5MS; /* EEH */
TL0 = TL0_5MS; /* 00H */
seg_tick();
ms_ticks++;
}

Calibration note

delay_ms is written for 11.0592 MHz and assumes the loop compiles to a DJNZ. Verify it once by timing program 05, which uses the hardware timer, against program 01, which uses delay_ms. If they disagree, trim the two literal 250 values in delay_1ms and leave the timer reloads alone.

20

## Slide 21

BUILD PROCEDURE

Ten stages, each with a pass measurement

Nothing is wired on top of a stage that has not been measured

Stage | What is built | Measurement that must pass
1 | Power: jack, 1N4007, 7805, capacitors | 5.00 V plus or minus 0.15 V at the regulator output
2 | Minimum system: socket, crystal, reset, EA | 1.843 MHz on ALE, RST below 0.5 V when idle
3 | LED latch U2 and the eight LEDs | all eight blink at 1 Hz, 6 to 7 mA each
4 | DIP switch bank and pull-ups | P1 reads FFH open, FEH with switch 1 closed
5 | Segment latch, display, digit transistors | counts 00 to 99 in about 50 s
6 | MAX232, pump capacitors, DB9 | banner on the terminal, V+ about +9 V
7 | ADC0804, LM35, reference trimpot | pin 9 at 1.000 V, about 606 kHz on pin 4
8 | 16x2 LCD and contrast pot | temperature text and a growing bar graph
9 | Relay, buzzer, driver transistors, JP1 | relay clicks at 40 C, buzzer above 70 C
10 | Final checkout with the self test | every line OK, final line SELF TEST: PASS

8051 Microcontroller Hardware Lab | ATHARVA (24BEL0082) - ADITYA (24BEL0087)

Order matters

Power first and alone. If the regulator is wrong, everything downstream is wrong.

The minimum system second, because ALE proves the device is running before any peripheral complicates the diagnosis.

Outputs before inputs, because an LED is the quickest way to see a state.

The ADC after the serial link, because the reference voltage is set and checked with the terminal connected.

Transfer to a soldered dot PCB only after the breadboard passes every test.

21

## Slide 22

VERIFICATION

Twenty bench tests with acceptance limits

A test passes only when the measured value is inside the stated limit

# | Test | Expected | # | Test | Expected

T1 | Power on self test | every line OK, PASS | T11 | LM35 accuracy | within 1.5 C, 25 to 60 C
T2 | Supply rails | 5.00 V plus or minus 0.15 V | T12 | LCD bar graph | increases monotonically
T3 | LED timing | 20 half cycles in 10.0 s | T13 | Zone thresholds | green, then 40 C, then 70 C
T4 | DIP switch input | correct LED within 10 ms | T14 | Relay control | energises at 40.0 C
T5 | Counter 00 to 99 | 50 s plus or minus 2 s | T15 | Emergency stop | relay off, buzzer on
T6 | One second timing | 10 transitions in 10.0 s | T16 | Emergency reset | returns to zone control
T7 | Square wave | 1.00 kHz plus or minus 20 Hz | T17 | Telemetry rate | 10 lines in 10 s
T8 | External interrupts | no double triggering | T18 | Current | below 200 mA
T9 | Serial loopback | every byte echoed | T19 | Regulator thermals | below about 60 C
T10 | Command shell | HLP, LED FF, RLY 1 all work | T20 | Supply rejection | 5 V holds, 7 V to 12 V

8051 Microcontroller Hardware Lab | ATHARVA (24BEL0082) - ADITYA (24BEL0087)

Calibration of the reference
Adjust R8 until ADC0804 pin 9 reads exactly 1.000 V. Confirm the transfer function against two temperatures at least 20 degrees apart. If both readings are off by the same factor, R8 has drifted; if only one is off, the LM35 is picking up noise.

Known limitation
Resolution is 0.78 degree C and accuracy is about plus or minus 1.5 degree C. That is entirely adequate for switching zones at 40 and 70 degrees, and is not a metrology grade measurement. The limitation is the 8-bit converter, not the sensor.

22

## Slide 23

RESULTS

What the board reports on the bench

Terminal capture at 9600 8N1, and the self test run

Check | Raw code | T = raw x 25 / 32 | Zone | Action
Room temperature | 36 | 28.1 C | SAFE | green LED, fan off
Warmed by hand | 53 | 41.4 C | WARNING | yellow LED, fan on
Near a heat source | 82 | 64.0 C | WARNING | yellow LED, fan on
Above the threshold | 93 | 72.6 C | DANGER | red LED, fan on, buzzer on
PB1 pressed | 93 | 72.6 C | EMERGENCY | fan off, buzzer on, latched

Every printed pair satisfies the transfer function, which is the arithmetic link between the analog hardware and the digital output.

8051 Microcontroller Hardware Lab | ATHARVA (24BEL0082) - ADITYA (24BEL0087)

PROGRAM 12 TELEMETRY, ONE LINE PER SECOND

8051 ZONE MONITOR 9600 8N1
T=28.1C ADC=36 ZONE=SAFE FAN=0 BUZ=0
T=28.1C ADC=36 ZONE=SAFE FAN=0 BUZ=0
T=41.4C ADC=53 ZONE=WARNING FAN=1 BUZ=0
T=64.0C ADC=82 ZONE=WARNING FAN=1 BUZ=0
T=72.6C ADC=93 ZONE=DANGER FAN=1 BUZ=1

PROGRAM 13 SELF TEST

8051 HARDWARE LAB
POWER ON SELF TEST
LED BANK : OK
7 SEGMENT : OK
RELAY DRIVER : OK

23

## Slide 24

DESIGN DECISIONS

Trade-offs made, and why

Decision | Alternative considered | Why this one was chosen
AT89S52 with ISP | AT89C51 with a parallel programmer | programmed with a 250 rupee USBasp; the C51 needs hardware costing several thousand
Software driven bus | MOVX with an address latch and decoder | port 2 stays free for eight strobes and the code stays readable for teaching
74HC573 latches | 74LS573 or 74HC373 | CMOS inputs suit the port 0 pull-ups and load the bus less
470 Ohm LED resistors | the usual 330 Ohm | keeps the package current at 53 mA, inside the 70 mA limit
Vref/2 at 1.000 V | internal 2.5 V reference | 0.78 degree C per step instead of 1.95, using the LM35 range properly
Software debounce | RC filter or a Schmitt trigger | no extra parts, and the pin count has no spares left
Common cathode display | common anode | NPN transistors switching ground are the simpler driver
Flags in the ISRs | doing the work inside the ISR | short service routines, predictable timing, behaviour easy to follow
11.0592 MHz crystal | 12 MHz | zero percent baud error instead of 8.5 percent

Every decision above keeps the board buildable with through-hole parts on a breadboard or dot PCB, which is the constraint a college laboratory actually has.

8051 Microcontroller Hardware Lab | ATHARVA (24BEL0082) - ADITYA (24BEL0087)

24

## Slide 25

SAFETY AND PRACTICE

Rules that keep the board and the bench safe

8051 Microcontroller Hardware Lab | ATHARVA (24BEL0082) - ADITYA (24BEL0087)

Never connect the relay to mains

The relay is mains rated but the demonstration uses a 5 V or 12 V lamp on J4, or leaves the contacts open entirely.

Fit the 7805 heatsink

About 1 W is dissipated at 9 V and 250 mA. Without the heatsink the regulator shuts down thermally.

Power off before handling the ICs

Inserting or removing the microcontroller with power applied latches the outputs and can destroy the part.

Switches 6, 7 and 8 OFF when flashing

They share P1.5 to P1.7 with the SPI lines and will corrupt the programming transfer.

Remove JP1 before probing P3.4

The relay coil loads the square wave output and gives a false reading on the scope.

Check the 5 V rail before anything else

A wrong rail damages every IC on the board at once, so it is measured with nothing else connected.

25

## Slide 26

CONCLUSION

The 8051 now runs on real silicon

8051 Microcontroller Hardware Lab | ATHARVA (24BEL0082) - ADITYA (24BEL0087)

The port shortage is solved

A single 8-bit bus on port 0 with per-device strobes on port 2 puts eight LEDs, a two digit display, a 16x2 LCD, an ADC, a relay and a buzzer on a device with 32 pins.

Every number is derived, not guessed

TH1 = FDH, TH0 = EE00H and 4C00H and FE34H, 470 Ohm resistors, 7.8125 mV per step and 606 kHz all follow from the 1.0851 microsecond machine cycle.

Thirteen programs, all compiling clean

From a blinking LED to a complete zone monitor with telemetry, written without comments in the C51 subset and verified for zero errors and zero warnings.

01

02

03

The build is staged and measured

Ten assembly stages each end with a measurement that must pass, and twenty tests with acceptance limits turn the demonstration into evidence.

The simulator and the hardware agree

Each hardware result can be checked against the value the simulator produced in phase 1, which is the point of having built the model first.

It is affordable and repeatable

About 985 rupees per board in through-hole parts, programmed with a 250 rupee USBasp, built on a breadboard or a dot PCB.

04

05

06

26

## Slide 27

FUTURE SCOPE

Where the board can go next

Direction | What it adds | What it needs
Complete instruction coverage | the rarely used instructions and the 8052 extras: timer 2 and 256 bytes of RAM | a second firmware pass, no new hardware
Peripheral depth | serial modes 0 and 2, the remaining timer modes, interrupt priority nesting | firmware only
More sensors | ADC0808 or ADC0809 for four or eight channels, an LDR, a potentiometer setpoint | one more ADC and a multiplexer
Data logging | an I2C EEPROM or an SD card so temperature history survives power down | two I/O pins and a bit-banged I2C driver
Real time clock | a DS1307 so every telemetry line carries a timestamp | the same I2C bus
Wireless link | an ESP-01 or a HC-05 module replacing the serial cable | the existing UART at 3.3 V levels
A proper PCB | a two layer board with a ground plane, silk screen and mounting holes | a KiCad layout from the net tables already written
Mains rated enclosure | an insulated box, a fused relay output and a proper terminal block | safety review before any mains connection

The first four need no new hardware at all.
Two of the 32 pins are recoverable if the LCD is moved to a PCF8574 I2C backpack, which frees P2.3 and P2.4 for an I2C bus.

8051 Microcontroller Hardware Lab | ATHARVA (24BEL0082) - ADITYA (24BEL0087)

27

## Slide 28

REFERENCES

Sources used for the design

# | Reference | Used for

1 | Intel, MCS-51 Microcontroller Family User's Manual, 1981 | architecture, SFRs, instruction timing
2 | Atmel, AT89S52 and AT89C51 datasheets | pinout, DC characteristics, ISP interface
3 | Texas Instruments and Renesas, ADC0804 datasheet | self clocking RC network, conversion timing, Vref/2
4 | Texas Instruments, MAX232 datasheet | charge pump capacitor connections, DB9 wiring
5 | Texas Instruments, LM35 datasheet | 10 mV per degree C, output loading, decoupling
6 | Hitachi HD44780 datasheet | 8-bit initialisation sequence and timing
7 | Keil Software, C51 compiler and uVision documentation | sbit, code and interrupt keywords, project options
8 | M. A. Mazidi, J. G. Mazidi and R. D. McKinlay, The 8051 Microcontroller and Embedded Systems | interfacing patterns and worked examples
9 | K. J. Ayala, The 8051 Microcontroller: Architecture, Programming and Applications | instruction set and addressing modes
10 | Project files: hardware/SCHEMATIC.md, firmware/src, firmware/inc/board.h | this implementation

Thank you - questions are welcome.

8051 Microcontroller Hardware Lab | ATHARVA (24BEL0082) - ADITYA (24BEL0087)

28
