AdityaRezan/8051-hardware-lab/docs/guide/images/concept-code-to-hardware.png

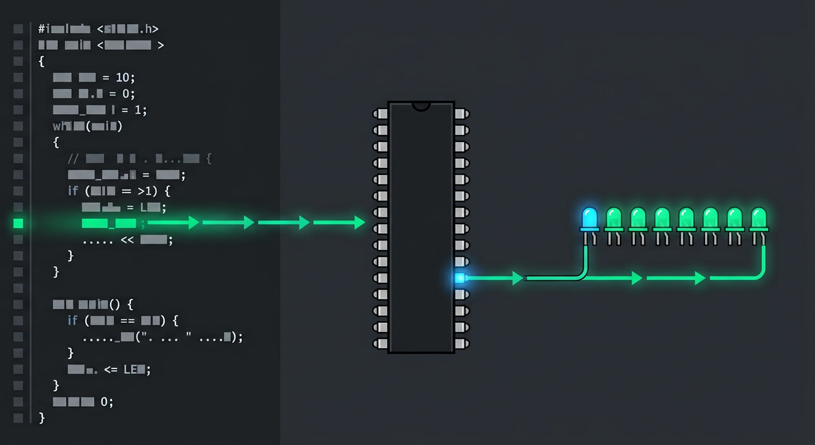
docs/guide/images/concept-code-to-hardware.png
