AdityaRezan/8051-hardware-lab/docs/guide/images/concept-control-loop.png

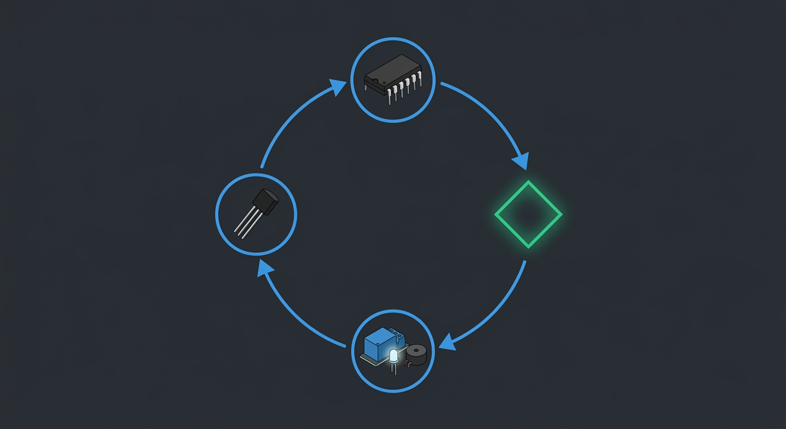
docs/guide/images/concept-control-loop.png
