AdityaRezan/8051-hardware-lab/docs/guide/images/concept-shared-bus.png

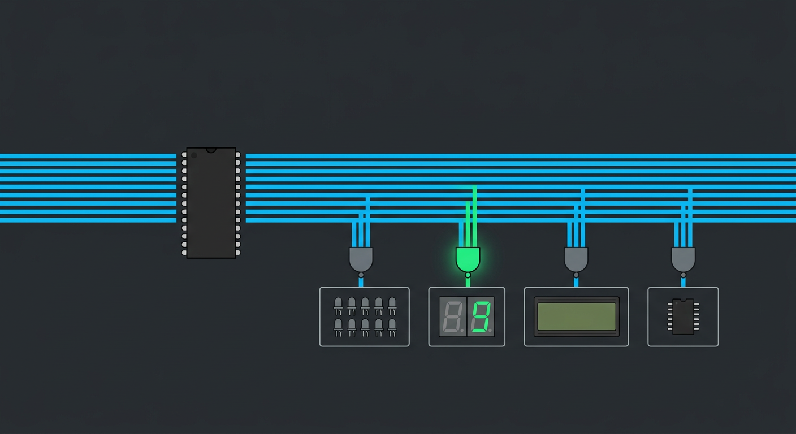
docs/guide/images/concept-shared-bus.png
