AdityaRezan/8051-hardware-lab/hardware/BOM.md

# Bill of Materials - 8051 Hardware Lab Board

Prices are indicative retail rates in India for the 2025-26 academic year and vary by vendor and quantity.
A single unit is populated per board; the two programmer entries (PRG1, PRG2) are shared lab tools, not per-board parts.

## Semiconductors and ICs

| Ref | Item | Value / part | Package | Qty | Unit (INR) | Line (INR) |
|---|---|---|---|---:|---:|---:|
| U1 | Microcontroller | AT89S52-24PU | DIP-40 | 1 | 120 | 120 |
| U2 | Octal latch | 74HC573N | DIP-20 | 1 | 25 | 25 |
| U3 | Octal latch | 74HC573N | DIP-20 | 1 | 25 | 25 |
| U4 | ADC | ADC0804LCN | DIP-20 | 1 | 95 | 95 |
| U5 | Line driver | MAX232N | DIP-16 | 1 | 45 | 45 |
| U6 | Temperature sensor | LM35DZ | TO-92 | 1 | 75 | 75 |
| U7 | Regulator | L7805CV | TO-220 | 1 | 12 | 12 |

**Subtotal: INR 397**

## Crystal and timing

| Ref | Item | Value / part | Package | Qty | Unit (INR) | Line (INR) |
|---|---|---|---|---:|---:|---:|
| Y1 | Crystal | 11.0592 MHz | HC-49U | 1 | 12 | 12 |

**Subtotal: INR 12**

## Discretes (transistors, diodes, LEDs)

| Ref | Item | Value / part | Package | Qty | Unit (INR) | Line (INR) |
|---|---|---|---|---:|---:|---:|
| Q1 | NPN transistor | BC547 | TO-92 | 1 | 2 | 2 |
| Q2 | NPN transistor | BC547 | TO-92 | 1 | 2 | 2 |
| Q3 | NPN transistor | BC547 | TO-92 | 1 | 2 | 2 |
| Q4 | NPN transistor | BC547 | TO-92 | 1 | 2 | 2 |
| D1 | Rectifier diode | 1N4007 | DO-41 | 1 | 2 | 2 |
| D2 | Rectifier diode | 1N4007 | DO-41 | 1 | 2 | 2 |
| D3-D10 | LED 5 mm | Red green yellow mix | 5 mm | 8 | 1 | 8 |
| D11 | LED 5 mm | Green | 5 mm | 1 | 1 | 1 |

**Subtotal: INR 21**

## Displays, modules and output devices

| Ref | Item | Value / part | Package | Qty | Unit (INR) | Line (INR) |
|---|---|---|---|---:|---:|---:|
| LCD1 | Character LCD | 16x2 HD44780 JHD162A | Module | 1 | 160 | 160 |
| DSP1 | 7-segment display | 2 digit 0.56 in common cathode | Module | 1 | 35 | 35 |
| RLY1 | Relay | SRD-05VDC-SL-C SPDT | Module | 1 | 55 | 55 |
| BZ1 | Buzzer | 5 V continuous | Module | 1 | 25 | 25 |

**Subtotal: INR 275**

## Switches and input devices

| Ref | Item | Value / part | Package | Qty | Unit (INR) | Line (INR) |
|---|---|---|---|---:|---:|---:|
| SW1 | DIP switch | 8 way SPST | DIP-16 | 1 | 30 | 30 |
| PB1 | Push button | 6x6 mm tactile | PTH | 1 | 3 | 3 |
| PB2 | Push button | 6x6 mm tactile | PTH | 1 | 3 | 3 |
| PB3 | Push button | 6x6 mm tactile | PTH | 1 | 3 | 3 |

**Subtotal: INR 39**

## Resistors and networks

| Ref | Item | Value / part | Package | Qty | Unit (INR) | Line (INR) |
|---|---|---|---|---:|---:|---:|
| RN1 | Resistor network | 10 kOhm x 9 SIP | SIP-9 | 1 | 10 | 10 |
| RN2 | Resistor network | 10 kOhm x 9 SIP | SIP-9 | 1 | 10 | 10 |
| RN3 | Resistor network | 470 Ohm x 9 SIP | SIP-9 | 1 | 8 | 8 |
| RN4 | Resistor network | 470 Ohm x 9 SIP | SIP-9 | 1 | 8 | 8 |
| R1 | Resistor | 10 kOhm 0.25 W | Axial | 1 | 1 | 1 |
| R2 | Resistor | 4.7 kOhm 0.25 W | Axial | 2 | 1 | 2 |
| R3 | Resistor | 1 kOhm 0.25 W | Axial | 2 | 1 | 2 |
| R4 | Resistor | 1 kOhm 0.25 W | Axial | 3 | 1 | 3 |
| R5 | Resistor | 330 Ohm 0.25 W | Axial | 1 | 1 | 1 |
| R6 | Resistor | 10 kOhm 0.25 W | Axial | 1 | 1 | 1 |
| R7 | Resistor | 220 Ohm 0.25 W | Axial | 1 | 1 | 1 |
| R8 | Trimpot | 10 kOhm multiturn 3296 | PTH | 1 | 20 | 20 |
| R9 | Potentiometer | 10 kOhm | PTH | 1 | 15 | 15 |

**Subtotal: INR 82**

## Capacitors

| Ref | Item | Value / part | Package | Qty | Unit (INR) | Line (INR) |
|---|---|---|---|---:|---:|---:|
| C1 | Capacitor | 0.1 uF ceramic 104 | DIP | 1 | 1 | 1 |
| C2 | Capacitor | 10 uF 16 V electrolytic | Radial | 1 | 3 | 3 |
| C3 | Capacitor | 30 pF ceramic | DIP | 2 | 1 | 2 |
| C4 | Capacitor | 100 uF 25 V electrolytic | Radial | 1 | 6 | 6 |
| C5 | Capacitor | 100 uF 16 V electrolytic | Radial | 1 | 5 | 5 |
| C6 | Capacitor | 0.1 uF ceramic 104 | DIP | 6 | 1 | 6 |
| C7 | Capacitor | 1 uF 16 V electrolytic | Radial | 4 | 2 | 8 |
| C8 | Capacitor | 150 pF ceramic | DIP | 1 | 2 | 2 |
| C9 | Capacitor | 0.1 uF ceramic 104 | DIP | 1 | 1 | 1 |
| C10 | Capacitor | 0.1 uF ceramic 104 | DIP | 1 | 1 | 1 |

**Subtotal: INR 35**

## Sockets, connectors and jumpers

| Ref | Item | Value / part | Package | Qty | Unit (INR) | Line (INR) |
|---|---|---|---|---:|---:|---:|
| S1 | IC socket | 40 pin turned pin | DIP-40 | 1 | 35 | 35 |
| S2 | IC socket | 20 pin | DIP-20 | 3 | 5 | 15 |
| S3 | IC socket | 16 pin | DIP-16 | 1 | 6 | 6 |
| J1 | DC power jack | 5.5 x 2.1 mm | PTH | 1 | 12 | 12 |
| J2 | Serial connector | DB9 female right angle | PTH | 1 | 25 | 25 |
| J3 | ISP header | 2x5 pin male | Header | 1 | 10 | 10 |
| J4 | Screw terminal | 2 pin 5.08 mm | PTH | 1 | 8 | 8 |
| J5 | Screw terminal | 3 pin 5.08 mm | PTH | 1 | 8 | 8 |
| JP1 | Jumper | 2 pin male plus shunt | Header | 1 | 5 | 5 |

**Subtotal: INR 124**

## Power, PCB and tooling

| Ref | Item | Value / part | Package | Qty | Unit (INR) | Line (INR) |
|---|---|---|---|---:|---:|---:|
| HS1 | Heatsink | TO-220 clip on | TO-220 | 1 | 10 | 10 |
| PCB1 | General purpose PCB | 7 x 9 cm dot board | PCB | 1 | 40 | 40 |
| WR1 | Hookup wire | 22 AWG single core | Reel | 1 | 60 | 60 |
| PWR1 | Power adapter | 9 V 1 A SMPS | Module | 1 | 120 | 120 |
| PRG1 | ISP programmer | USBasp | Module | 1 | 250 | 250 |
| PRG2 | Serial adapter | USB to RS-232 DB9 | Module | 1 | 250 | 250 |

**Subtotal: INR 730**

## Cost summary

| Item | Amount (INR) |
|---|---:|
| Components on one board | 985 |
| Power supply, PCB, wire and programmers | 730 |
| **Total for one complete working setup** | **1,715** |

The recurring cost of a second board is about INR 985 because the adapter and programmers are reused.

## Notes on sourcing

- AT89S52 is chosen over AT89C51 because it is programmed through SPI with a USBasp, which costs about INR 250, instead of a parallel programmer that costs several thousand rupees.
- 74HC573 is a transparent latch; the 74HC373 or 74LS573 also work but HC is preferred for CMOS 5 V logic and low loading on the P0 bus.
- Substitute MAX232A and use 0.1 uF charge pump capacitors, or use MAX3232 with 0.1 uF capacitors for 3.3 V tolerant operation.
- Any 16x2 HD44780 compatible display works; JHD162A, WH1602 and generic blue or green backlight modules are interchangeable.
- Any common cathode 2 digit 0.56 inch display works. A common anode display does not work with this driver and must not be substituted without changing the segment table and digit driver polarity.
