AdityaRezan/8051-hardware-lab/docs/guide/IMAGE_CREDITS.md

# Image credits

The photographs in `images/` were collected from public web sources for
educational use in this project report. Three illustrations were generated.

## Generated illustrations

| File | What it shows |
|---|---|
| `concept-code-to-hardware.png` | One line of code becoming one signal on one pin, and then light |
| `concept-shared-bus.png` | One eight line bus with four devices behind four gates, one open |
| `concept-control-loop.png` | The four beat loop: measure, convert, decide, act |

## Photographs

| File | Subject | Source |
|---|---|---|
| `mcu-at89s52.jpg` | AT89S52, 40 pin DIP | mytechnocare.com |
| `breadboard.jpg` | Solderless breadboard prototype | allpcb.com |
| `breadboard-2.jpg` | Solderless breadboard | kunkune.co.uk |
| `lcd-16x2.jpg` | 16x2 character LCD, HD44780 | voltatek.ca |
| `display-7seg.jpg` | Two digit seven segment display | ebay.com |
| `display-7seg-2.jpg` | Two digit seven segment display | thepihut.com |
| `sensor-lm35.jpg` | LM35 temperature sensor, TO-92 | e-gizmo.net |
| `adc0804.jpg` | ADC0804, DIP-20 | easybom.com |
| `multimeter.jpg` | Digital multimeter, DC volts | realpars.com |
| `oscilloscope.jpg` | Oscilloscope showing a square wave | keysight.com |
| `relay.jpg` | 5 V SPDT PCB relay | techdelivers.com |
| `crystal.jpg` | 11.0592 MHz HC-49U crystal | aliexpress.us |
| `programmer-usbasp.jpg` | USBasp ISP programmer | flyingtech.co.uk |
| `leds.jpg` | 5 mm LED assortment | amazon.com |
| `regulator-7805.jpg` | L7805 regulator, TO-220 with heatsink | amazon.com |
| `dipswitch.jpg` | Eight way DIP switch | avlis-co.com |

Photographs are reference images of the part types used. They show the
components, not this specific assembled board.
