AdityaRezan/8051-hardware-lab/docs/guide/images/adc0804.jpg

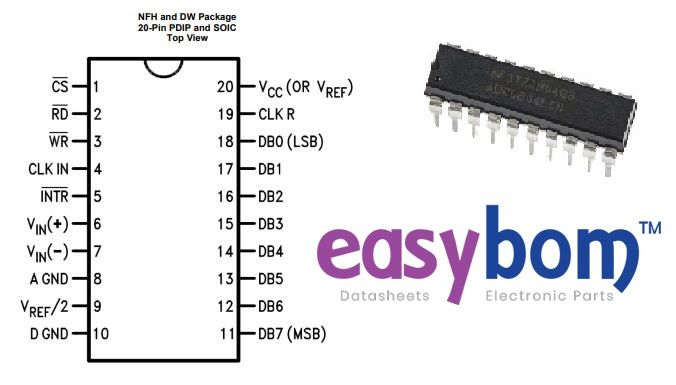
docs/guide/images/adc0804.jpg
