AdityaRezan/8051-hardware-lab/docs/guide/images/breadboard-2.jpg

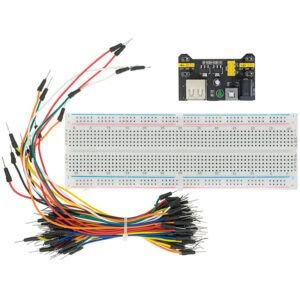
docs/guide/images/breadboard-2.jpg
