AdityaRezan/8051-hardware-lab/docs/guide/images/crystal.jpg

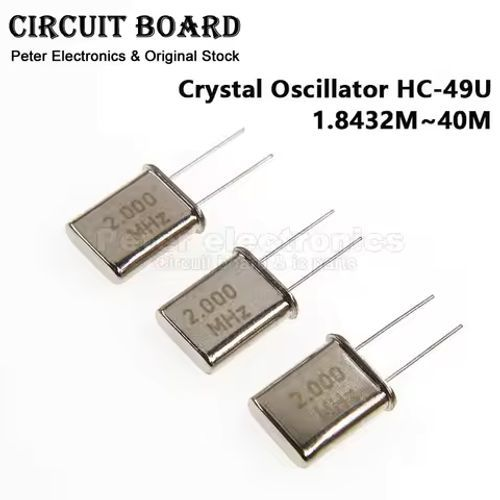
docs/guide/images/crystal.jpg
