AdityaRezan/8051-hardware-lab/docs/guide/images/display-7seg-2.jpg

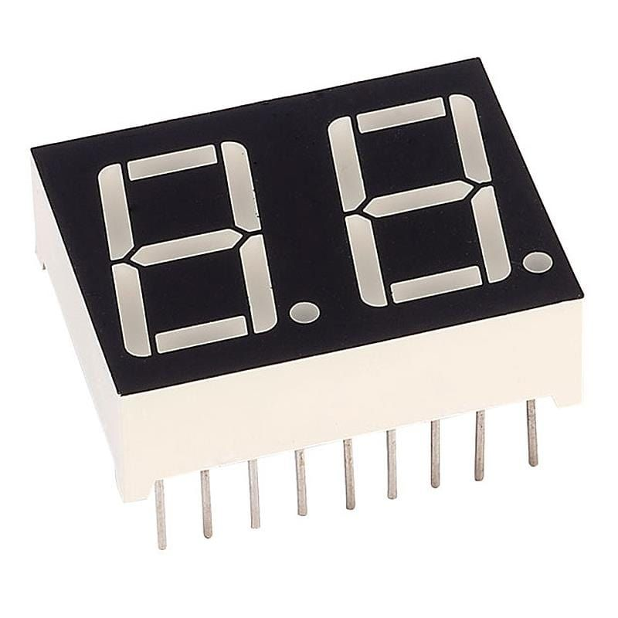
docs/guide/images/display-7seg-2.jpg
