AdityaRezan/8051-hardware-lab/docs/guide/images/display-7seg.jpg

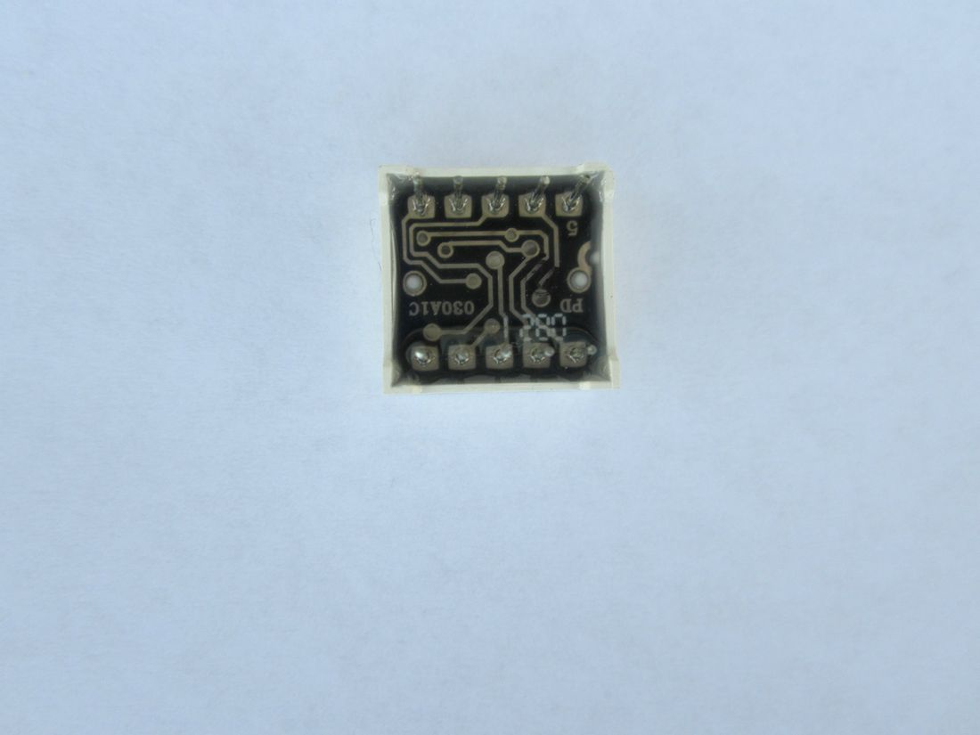
docs/guide/images/display-7seg.jpg
