AdityaRezan/8051-hardware-lab/docs/guide/images/lcd-16x2.jpg

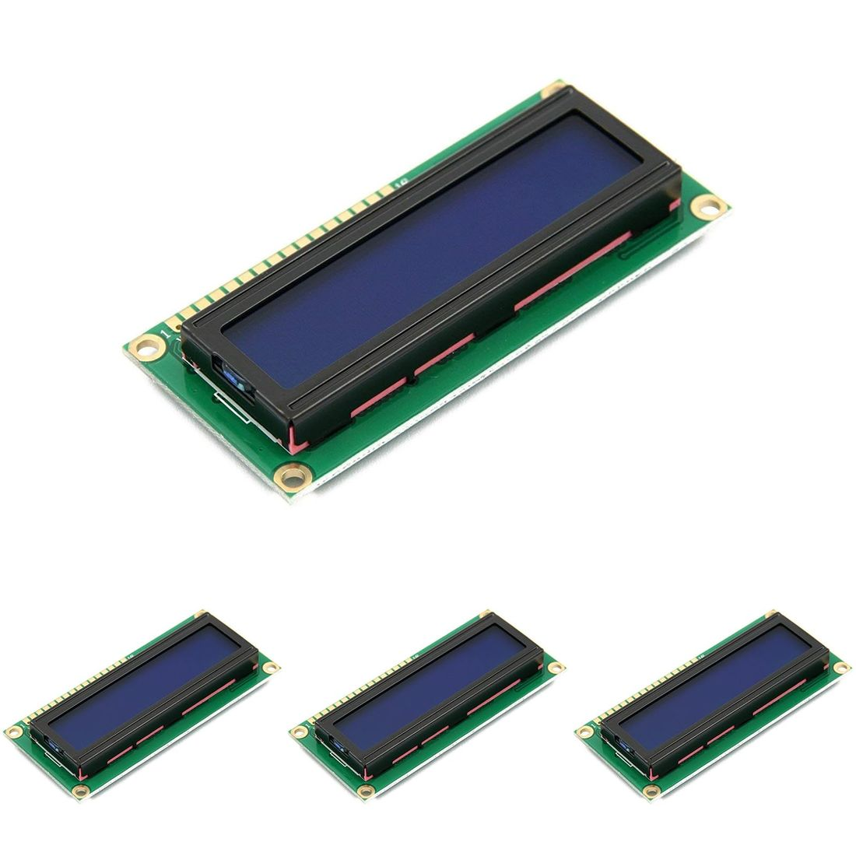
docs/guide/images/lcd-16x2.jpg
