AdityaRezan/8051-hardware-lab/docs/guide/images/leds.jpg

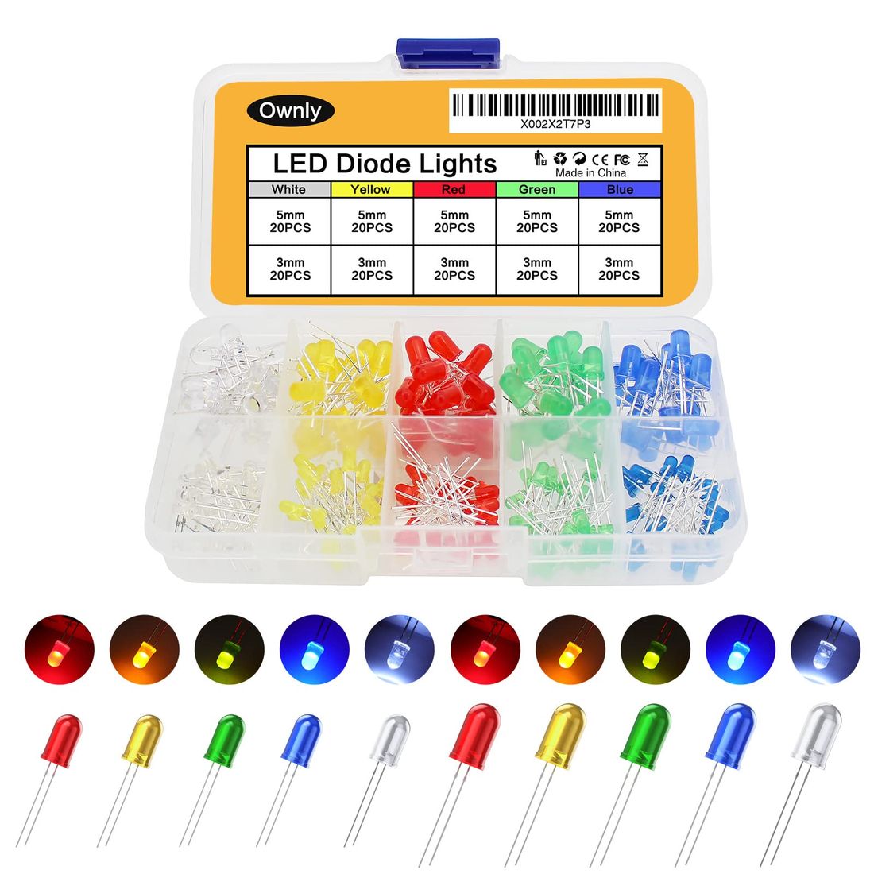
docs/guide/images/leds.jpg
