AdityaRezan/8051-hardware-lab/docs/guide/images/mcu-at89s52.jpg

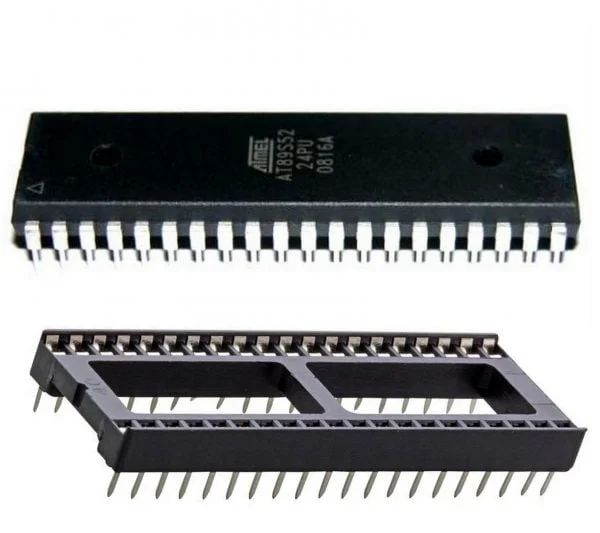
docs/guide/images/mcu-at89s52.jpg
