AdityaRezan/8051-hardware-lab/docs/guide/images/multimeter.jpg

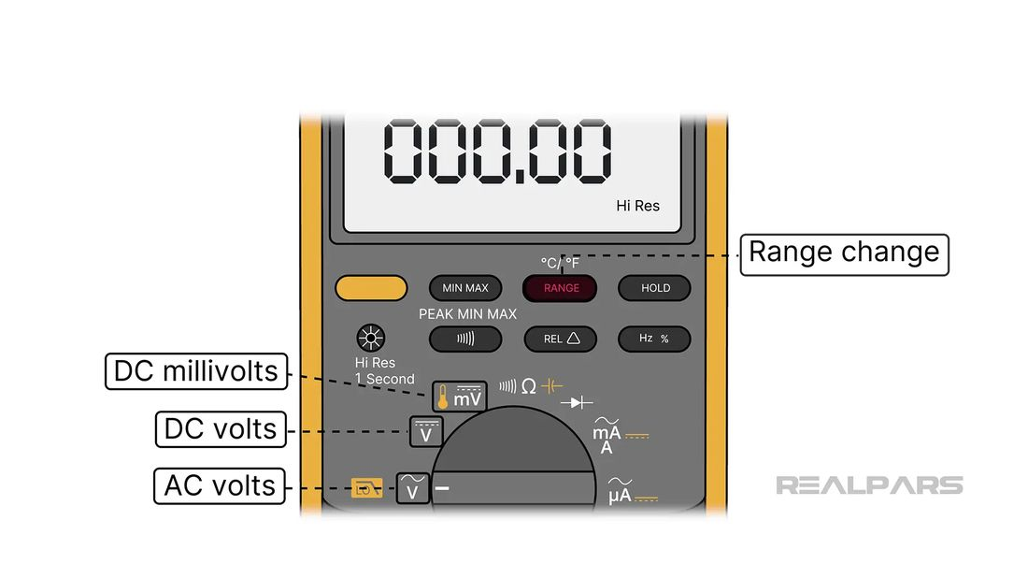
docs/guide/images/multimeter.jpg
