AdityaRezan/8051-hardware-lab/docs/guide/images/oscilloscope.jpg

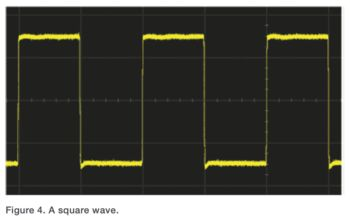
docs/guide/images/oscilloscope.jpg
