AdityaRezan/8051-hardware-lab/docs/guide/images/programmer-usbasp.jpg

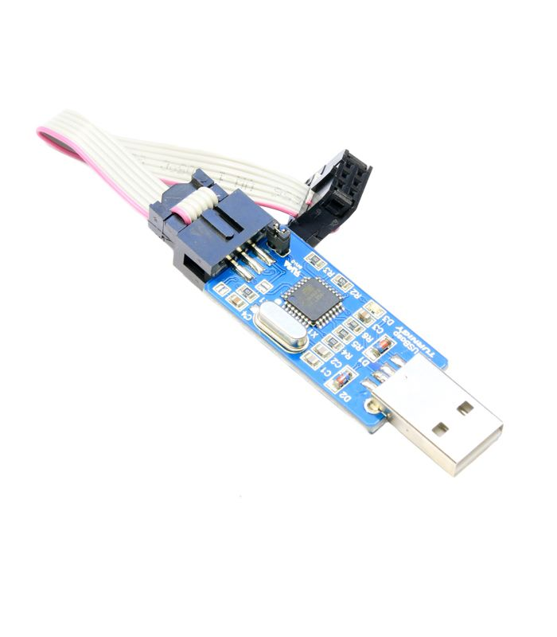
docs/guide/images/programmer-usbasp.jpg
