AdityaRezan/8051-hardware-lab/docs/guide/images/regulator-7805.jpg

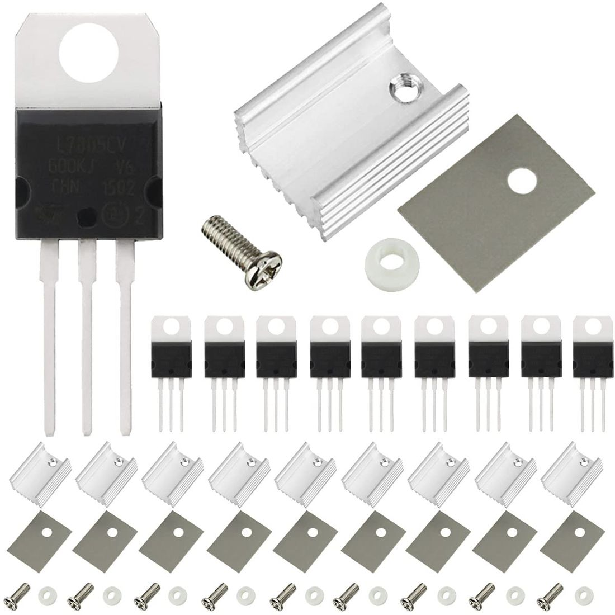
docs/guide/images/regulator-7805.jpg
