AdityaRezan/8051-hardware-lab/docs/guide/images/relay.jpg

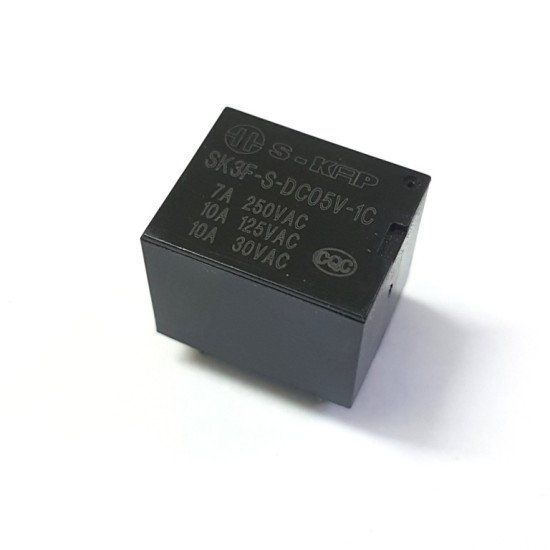
docs/guide/images/relay.jpg
