AdityaRezan/8051-hardware-lab/docs/guide/images/sensor-lm35.jpg

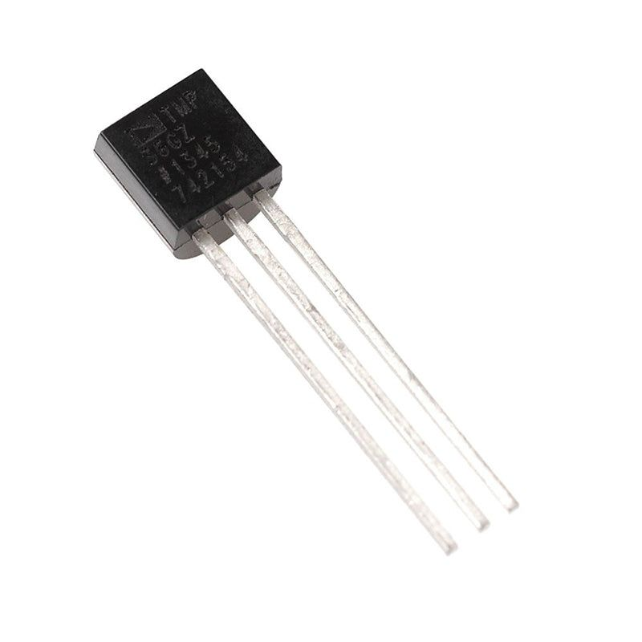
docs/guide/images/sensor-lm35.jpg
