AdityaRezan/8051-hardware-lab/docs/guide/video/frames/bench-laptop.jpg

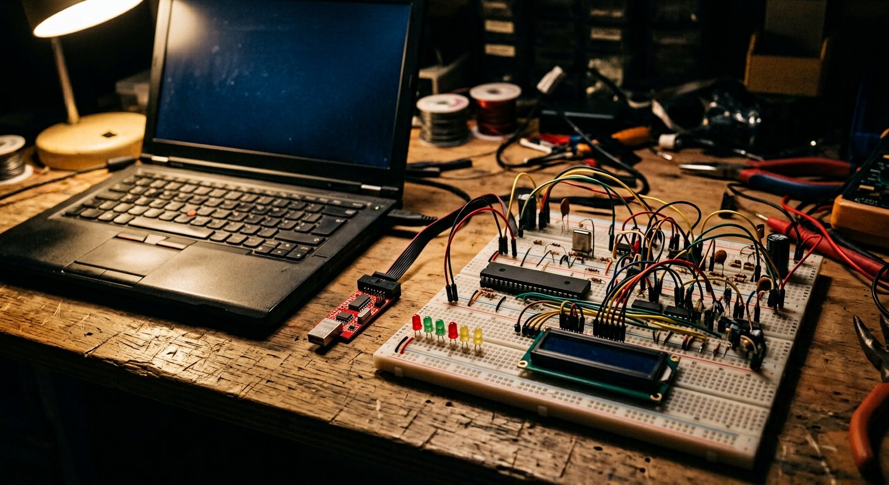
docs/guide/video/frames/bench-laptop.jpg
