AdityaRezan/8051-hardware-lab/docs/guide/video/frames/board-complete.jpg

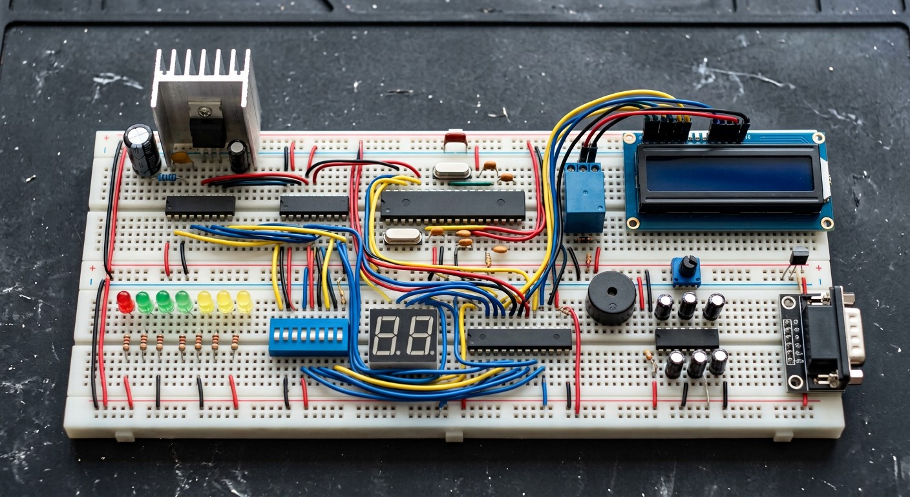
docs/guide/video/frames/board-complete.jpg
