AdityaRezan/8051-hardware-lab/docs/guide/video/frames/board-emergency.jpg

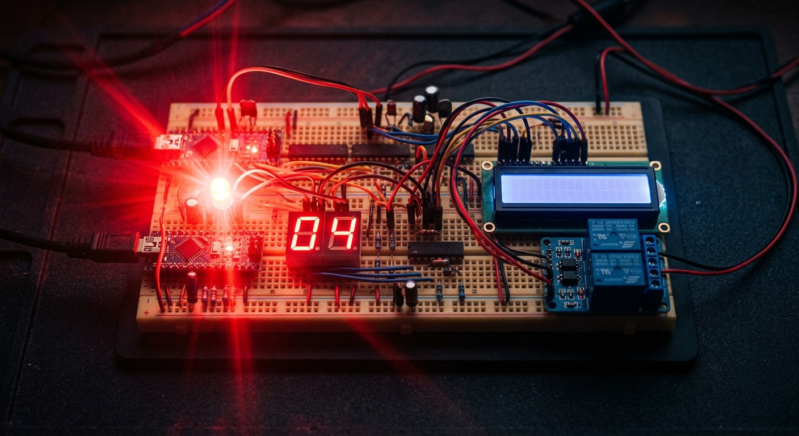
docs/guide/video/frames/board-emergency.jpg
