AdityaRezan/8051-hardware-lab/docs/guide/video/frames/board-running-danger.jpg

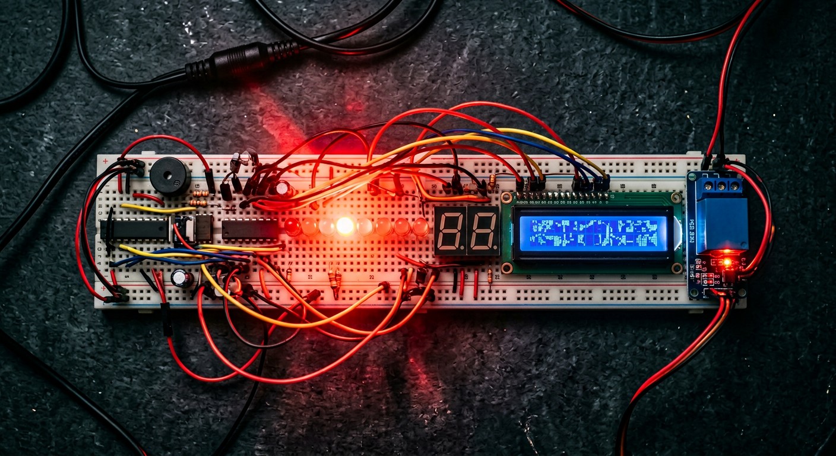
docs/guide/video/frames/board-running-danger.jpg
