AdityaRezan/8051-hardware-lab/docs/guide/video/frames/board-running-safe.jpg

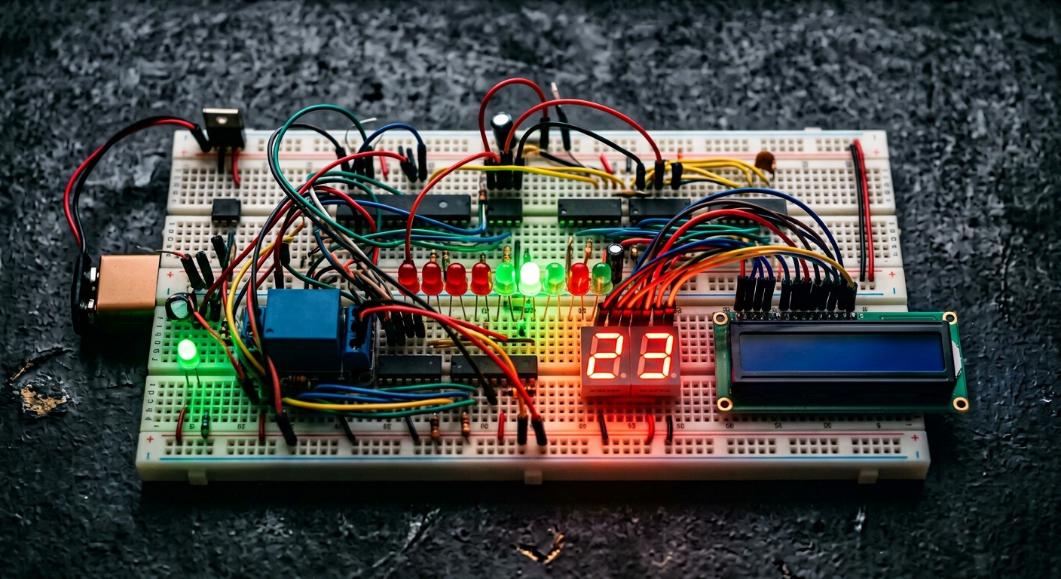
docs/guide/video/frames/board-running-safe.jpg
