AdityaRezan/8051-hardware-lab/docs/guide/video/frames/board-stage-early.jpg

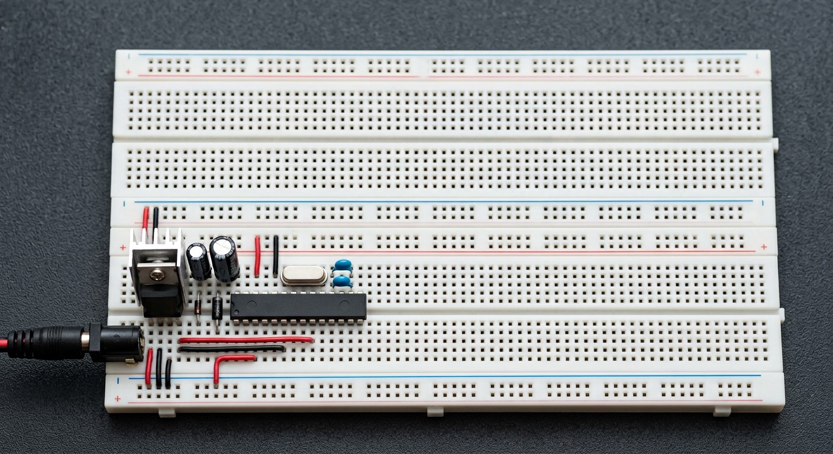
docs/guide/video/frames/board-stage-early.jpg
