AdityaRezan/8051-hardware-lab/docs/guide/video/frames/board-stage-mid.jpg

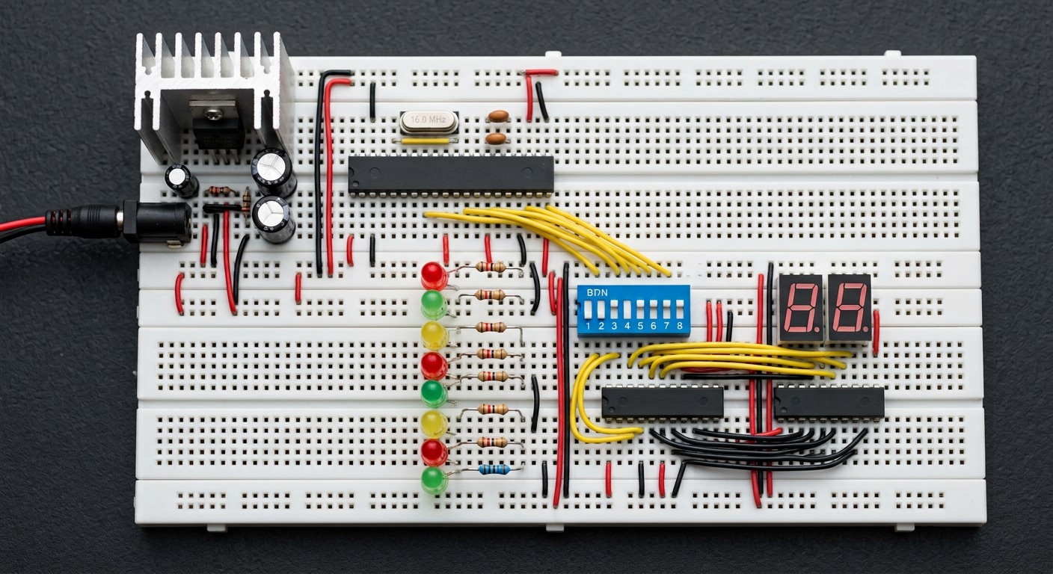
docs/guide/video/frames/board-stage-mid.jpg
