AdityaRezan/8051-hardware-lab/(commit log)

2026-10-20 Initial import: 8051 hardware lab (hardware design, Keil C51 firmware, docs)
    [BOM.csv]
2026-10-20 Add seven slide technical review deck with outline, wireframes and design system
    Adds a presentation architect deliverable: a 7 slide review deck aimed at a
    technical review committee, plus the specification that produced it.
    docs/8051_Hardware_Lab_Review_Deck.pptx
    Slide 1 Title and author metadata
    Slide 2 Problem statement and constraints
    Slide 3 Proposed architecture, system block diagram
    Slide 4 Hardware and software stack
    Slide 5 Implementation logic and control flow
    Slide 6 Results, benchmark metrics and trade-offs
    Slide 7 Scalability, future scope and conclusion
    Design system: charcoal #1E293B background, off-white #F1F5F9 text, Electric
    Blue #2563EB primary acce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
    [build_exec_deck.py, gen_wireframes.py]
2026-10-20 Add 5 minute narrated assembly video, generated board frames and shooting script
2026-10-20 Add flashing guide covering ISP wiring, Arduino as ISP and USBasp polarity
2026-10-20 Add START_HERE.md walking the whole project from install to running board
2026-10-20 Add SOFTWARE_RUNBOOK.md: software half as a tick-box path from laptop to running board
2026-10-21 Add results doc and printable two-page result sheet (PDF + generator)
